Varas10/ROBOT/Rapports/2.Générer un signal de lumière codée/Vlum (jaune) et Vc (bleu).jpg

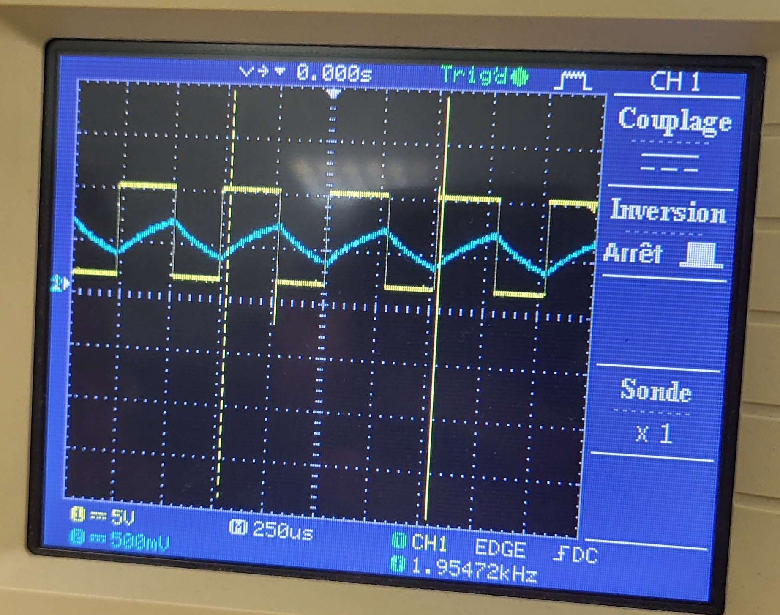
Rapports/2.Générer un signal de lumière codée/Vlum (jaune) et Vc (bleu).jpg
