Varas10/ROBOT/Rapports/6. Visualiser/6.VISUALISER.md

## Projet 6 – **Étude théorique de la visualisation de Vsuivi**

### Objectif :

Mettre en œuvre un système d’indication visuelle permettant de traduire l’état logique de la sortie **Vsuivi** (obtenue après démodulation du signal optique) en allumage ou extinction d’une **LED**. Ce retour visuel est essentiel pour valider la détection d’une piste claire (blanche) ou sombre (noire) par le robot suiveur.

### Données initiales (extrait du cahier des charges) :

|Surface|Vsuivi (V)|LED allumée|
|---|---|---|
|Blanche|≈ 6 V|Oui|
|Noire|≈ 0 V|Non|

### Solution proposée :

L’objectif est de commander une **diode électroluminescente (LED)** à partir de la tension **Vsuivi**. Pour cela, on utilise un montage de **comparateur à seuil** à base d’amplificateur opérationnel, qui :

- compare Vsuivi à une tension de référence (**Vref**, par exemple 3 V),
    
- commande la LED via un transistor de puissance (ex : **NPN** ou **MOSFET**),
    
- protège la LED par une résistance série adaptée.

### Calculs :

- Tension seuil choisie : **Vref = 3 V**
    
- Si Vsuivi>VrefVsuivi > VrefVsuivi>Vref, alors la LED s’allume (surface blanche détectée).
    
- Si Vsuivi<Vref, la LED reste éteinte (surface noire détectée).
    
- Résistance série pour la LED 
	$R_{LED} = V_{suivi} − V_{D}*I_{LED}=6V−2V*20mA=200 \Omega$ (valeur normalise E12 : 220 Ω) où $V_D$ est la chute de tension dans la LED rouge ≈ 2V).

### Adaptation d’impédance :

Le comparateur est conçu pour présenter une **impédance d’entrée élevée** et **ne pas charger le signal Vsuivi**, afin de préserver l'intégrité du signal issu du détecteur de crête.

### Simulation :

- Simulation effectuée dans **MicroCap** ou environnement similaire.
    
- Résultat attendu : la sortie bascule rapidement en fonction du dépassement du seuil Vref, et commande proprement l’allumage de la LED.

---

## Séance 6 – **Implémentation du montage et validation expérimentale**

### Objectif :

Réaliser physiquement le circuit de visualisation sur plaque d’essai, le tester avec des signaux réels et vérifier le bon fonctionnement de la LED en fonction de la valeur de **Vsuivi**.

### Montage réalisé :

- Comparateur avec AOP ou comparateur dédié (type LM393).
    
- Entrée non-inverseuse connectée à Vsuivi.
    
- Entrée inverseuse connectée à Vref fixée par pont diviseur de tension.
    
- Sortie du comparateur connectée à une LED + résistance via un **transistor de commutation NPN**.

### Expériences menées :

- Cas 1 – **Surface blanche** :
    
    - Vsuivi mesuré ≈ 6 V
        
    - Vsuivi > Vref → LED **allumée** 
		
	- ![[surface blanche- seance 6.jpg]]
- Cas 2 – **Surface noire** :
    
    - Vsuivi mesuré ≈ 0 V
        
    - Vsuivi < Vref → LED **éteinte** 
        
	- ![[surface noir - séance 6.jpg]]
### Ajustements :

- Si besoin, Vref peut être modifiée pour affiner la sensibilité du déclenchement.
    
- La résistance série peut être recalculée selon la couleur de la LED utilisée (chute de tension différente pour LED bleue, verte, etc.).

### Conclusion :

Le circuit de visualisation est opérationnel et conforme aux exigences. Il permet de **traduire visuellement l’état du capteur IR** après amplification et démodulation, ce qui est essentiel pour la vérification manuelle ou le débogage du système. Ce montage constitue la dernière étape de la chaîne de traitement du signal sur la carte SUIVI.****
