Varas10/ROBOT/La carte Suiveur.pptx

## La carte Suiveur

Par Julien & Evan

## Sommaire

- Schéma de fonction
- Les yeux
- Oscilateur
- Filtre
- Ampificateur
- Détecteur de crète
- LED d’état

## Schéma de fonction

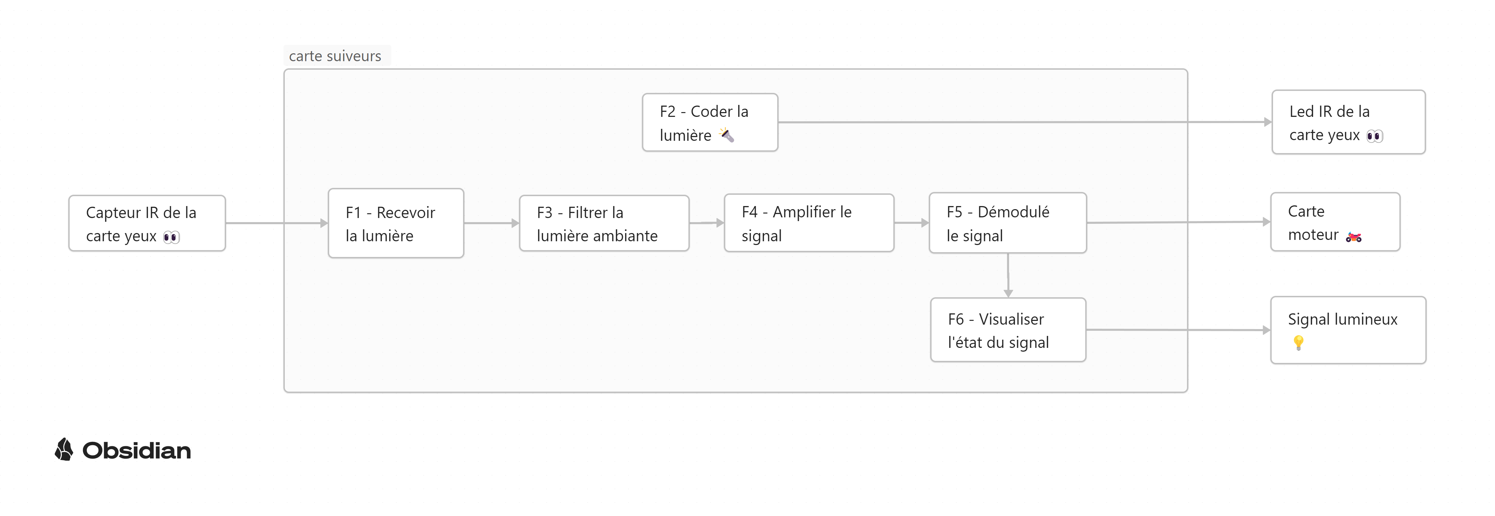
[picture p3: figure]

## Les yeux

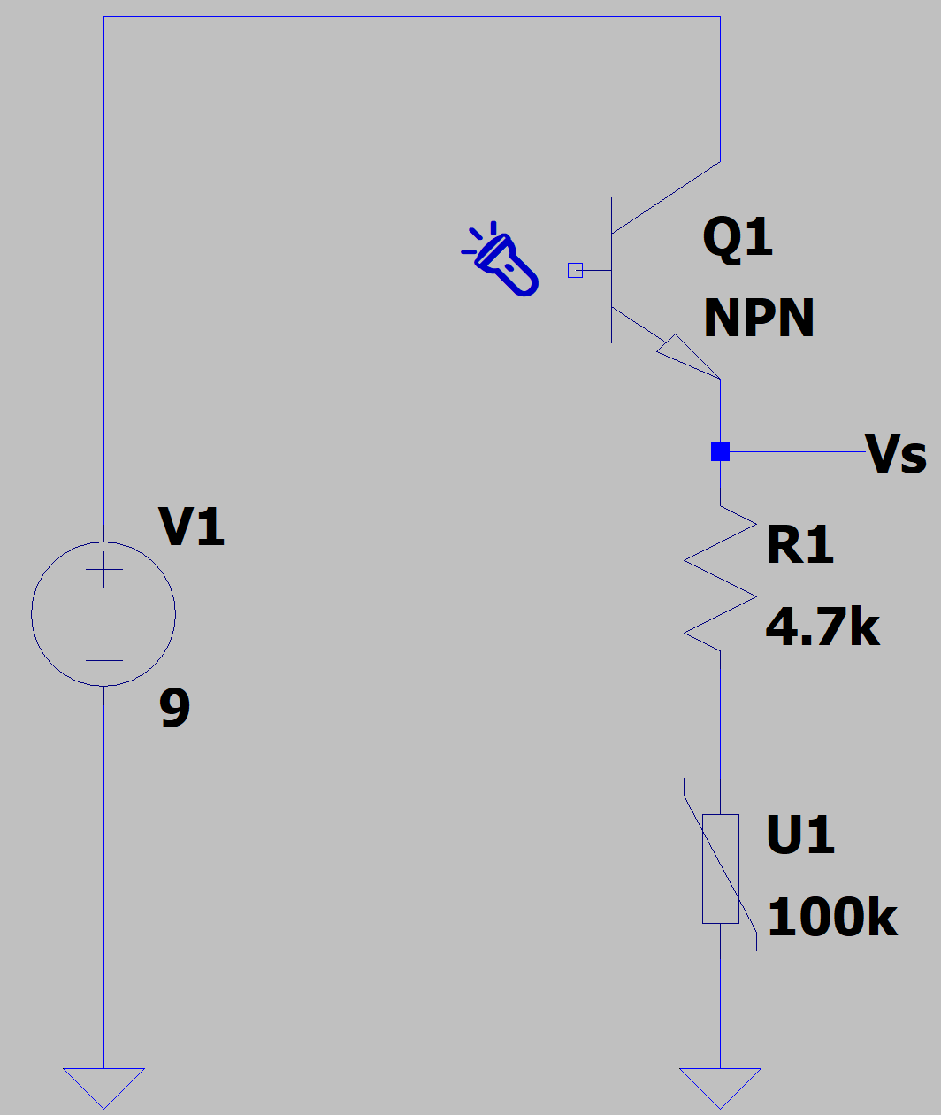
[picture p4: figure]
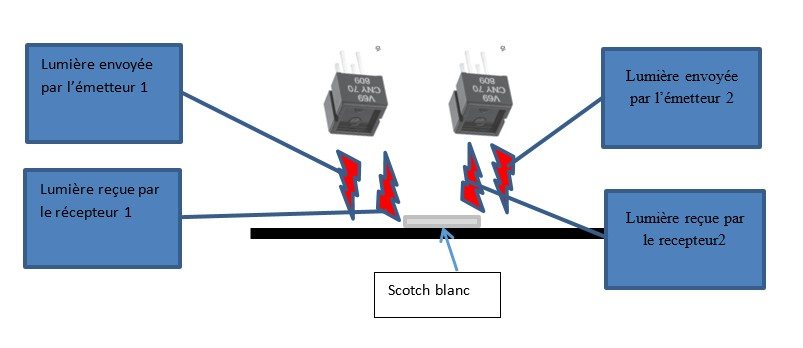
[picture p5: figure]
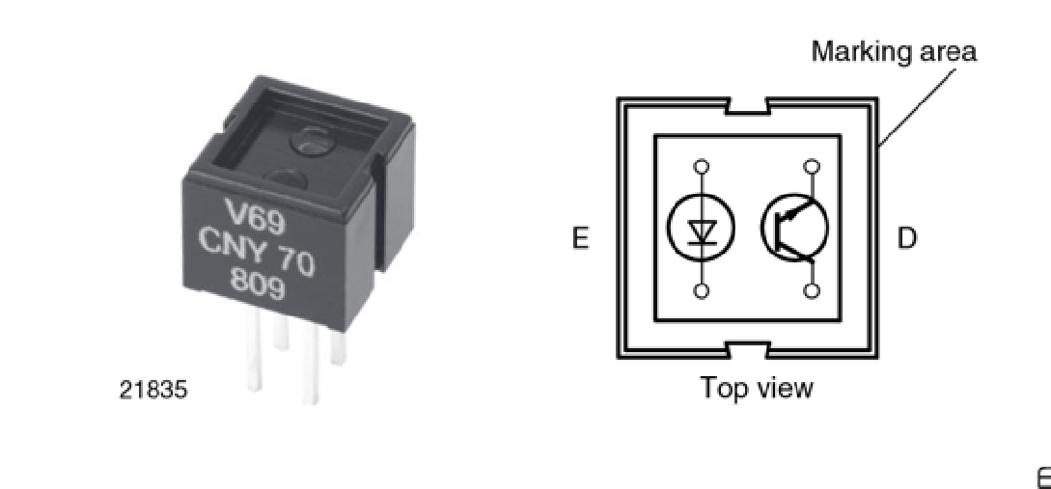
[picture p6: figure]

## Slide 5

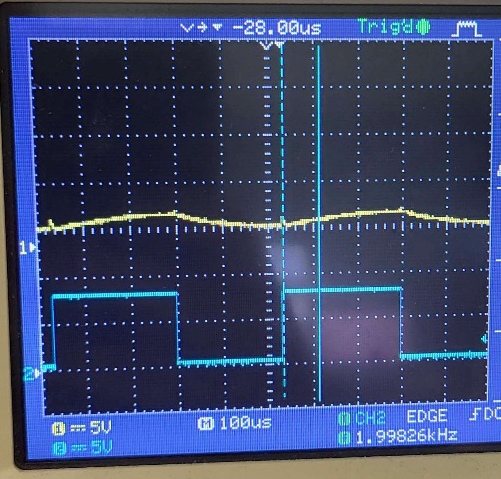
[picture p7: figure]

Surface noir

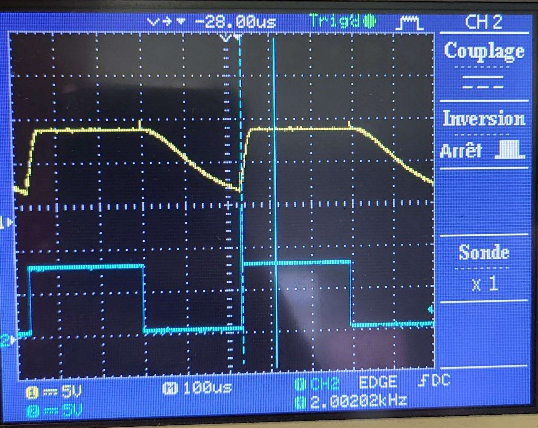
[picture p8: figure]

Surface Blanche

## Oscillateur

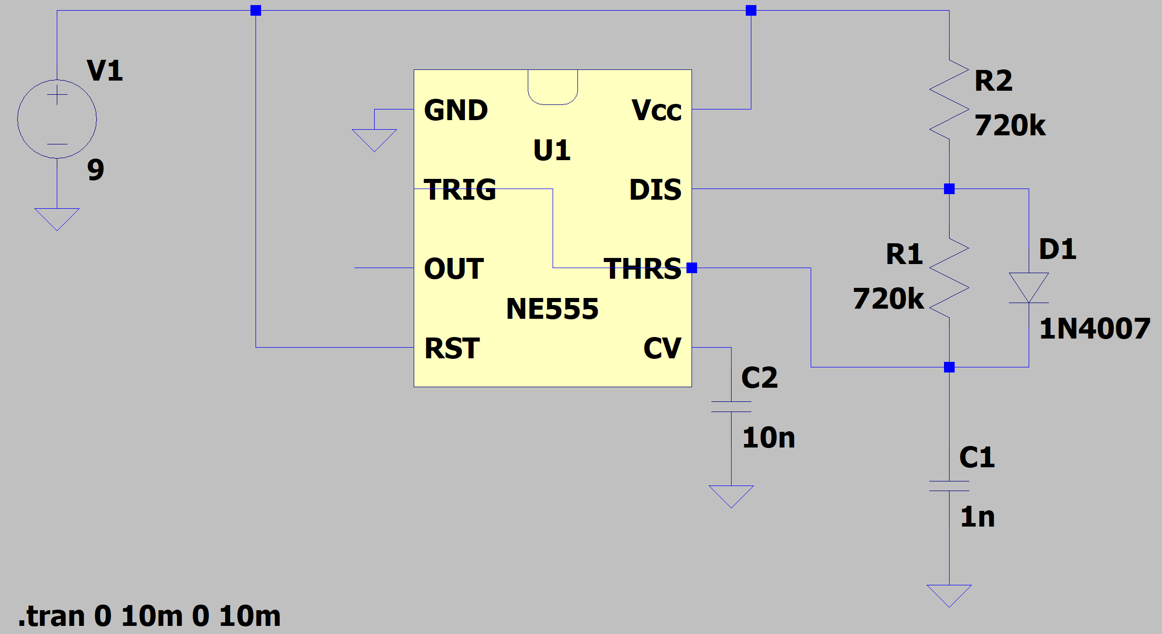
[picture p9: figure]
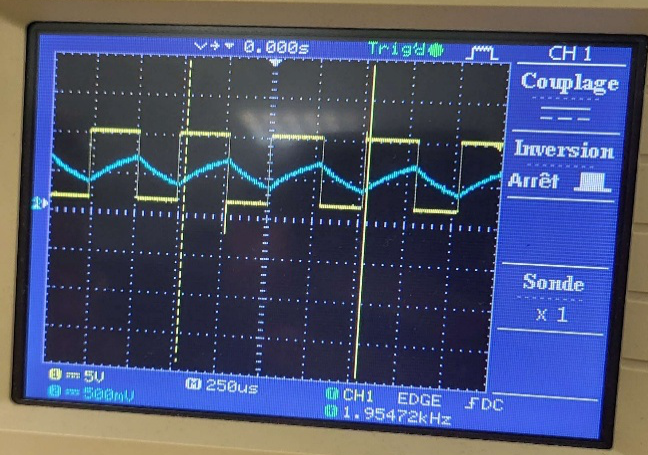
[picture p10: figure]

## Filtre

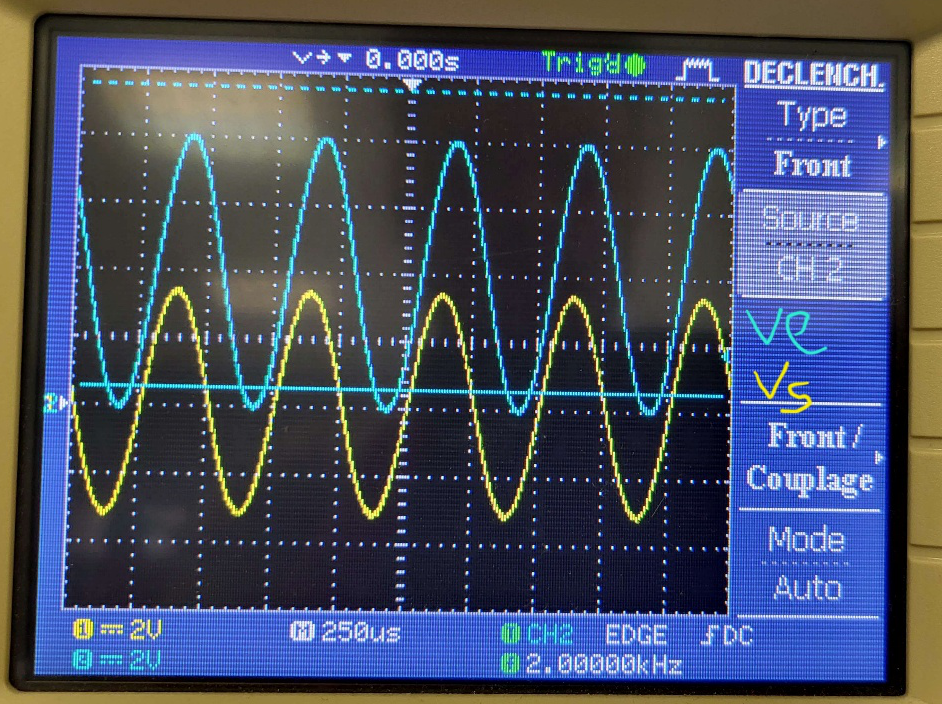
[picture p11: figure]

- Fc = 200Hz

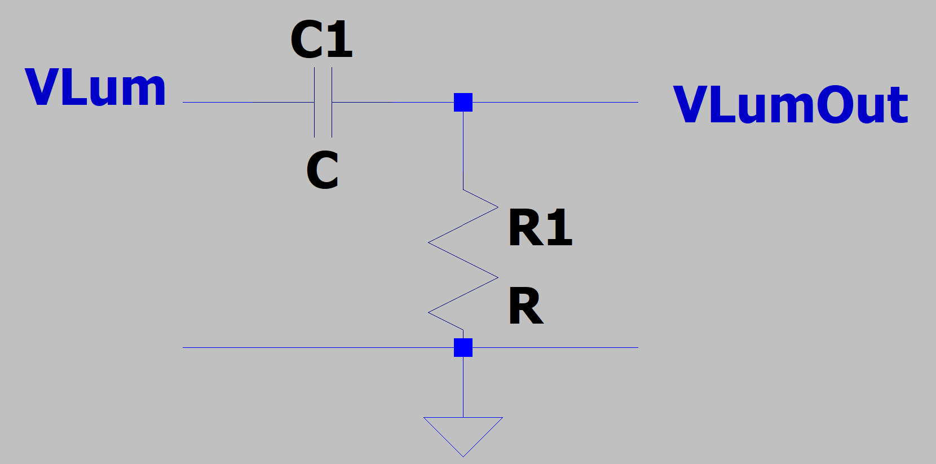
[picture p12: figure]
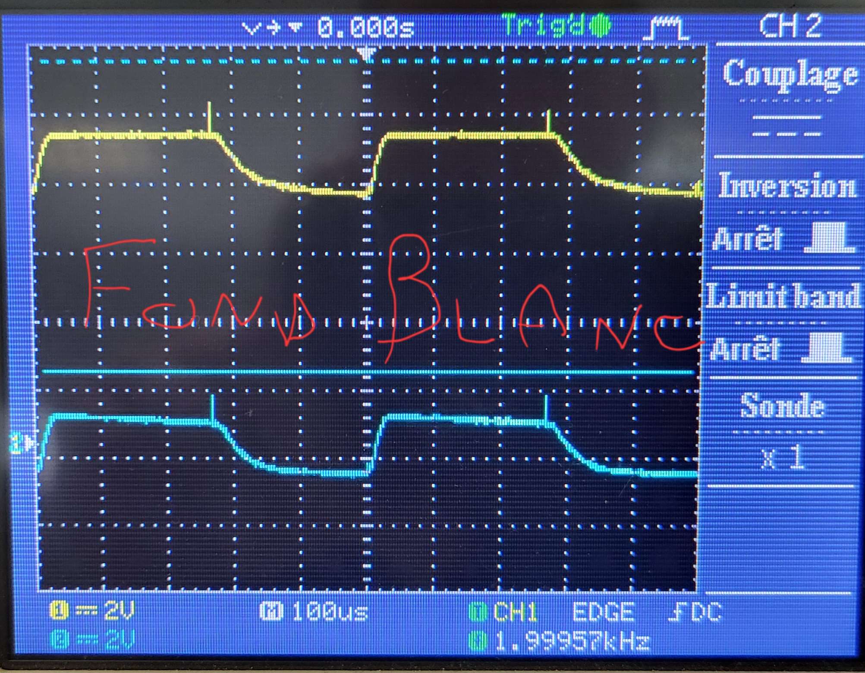
[picture p13: figure]
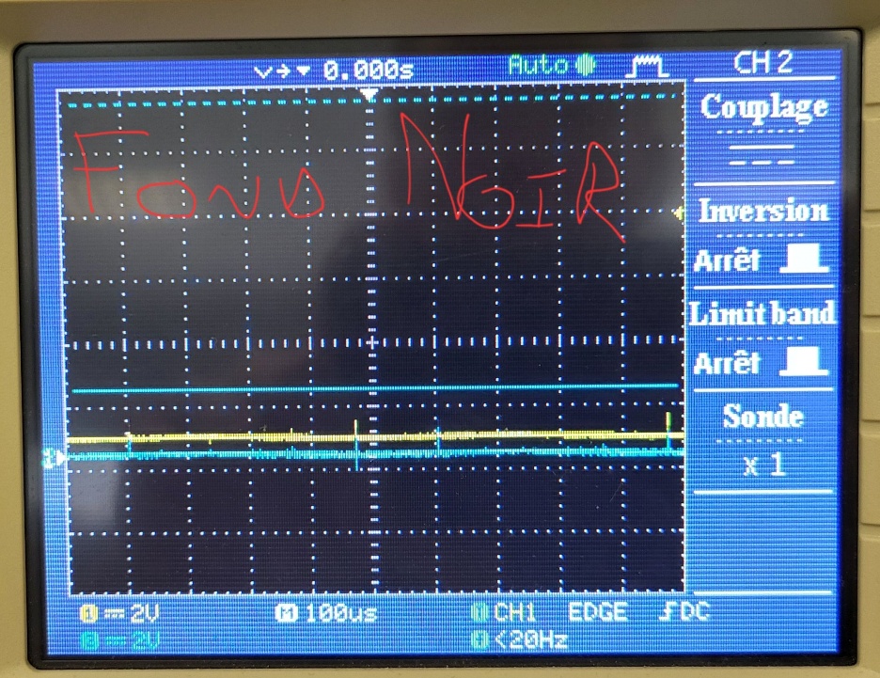
[picture p14: figure]

## Amplificateur

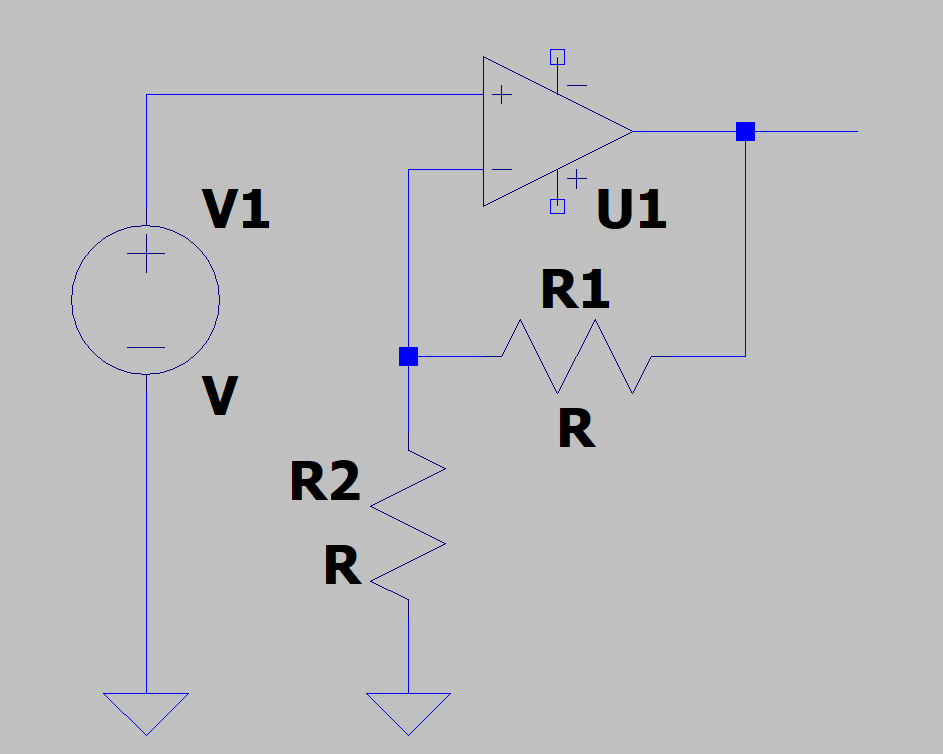
[picture p15: figure]
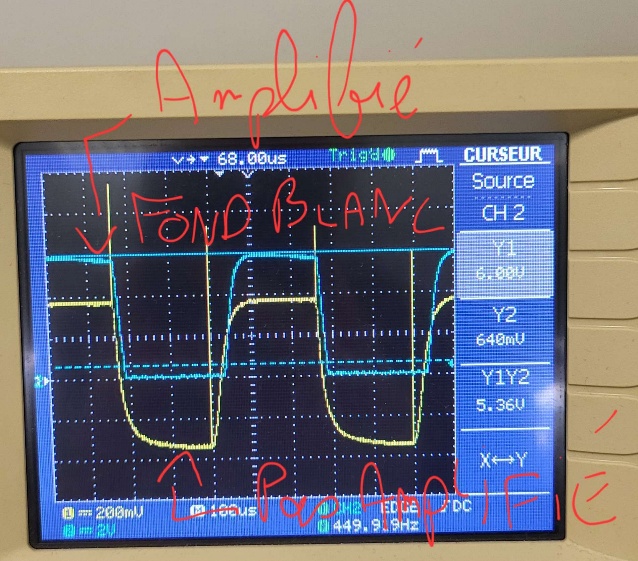
[picture p16: figure]
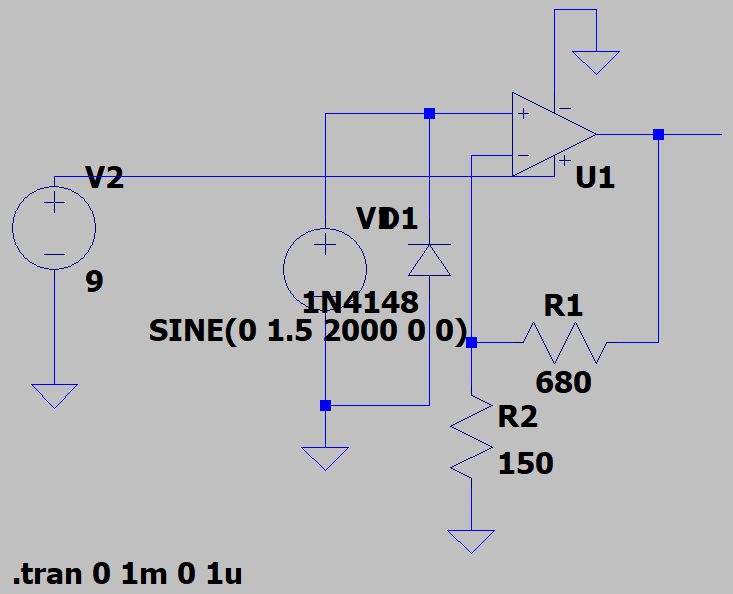
[picture p17: figure]
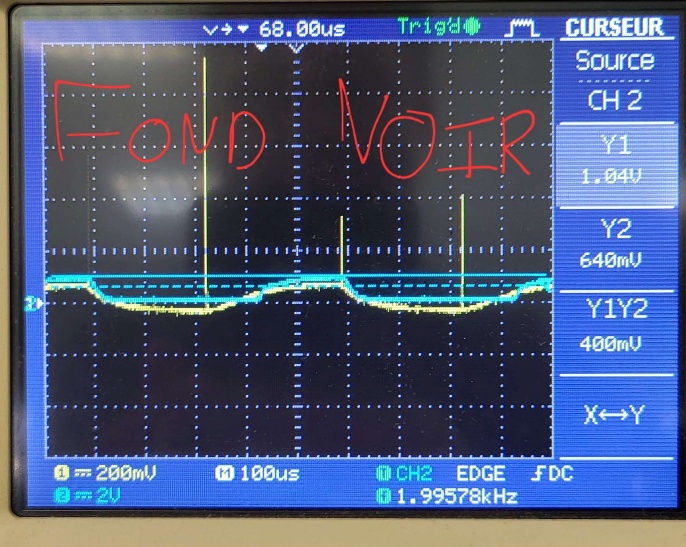
[picture p18: figure]

## Détecteur de crête

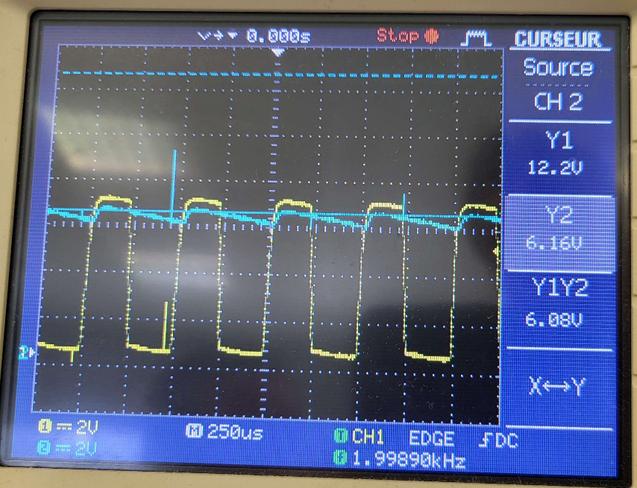
[picture p19: figure]
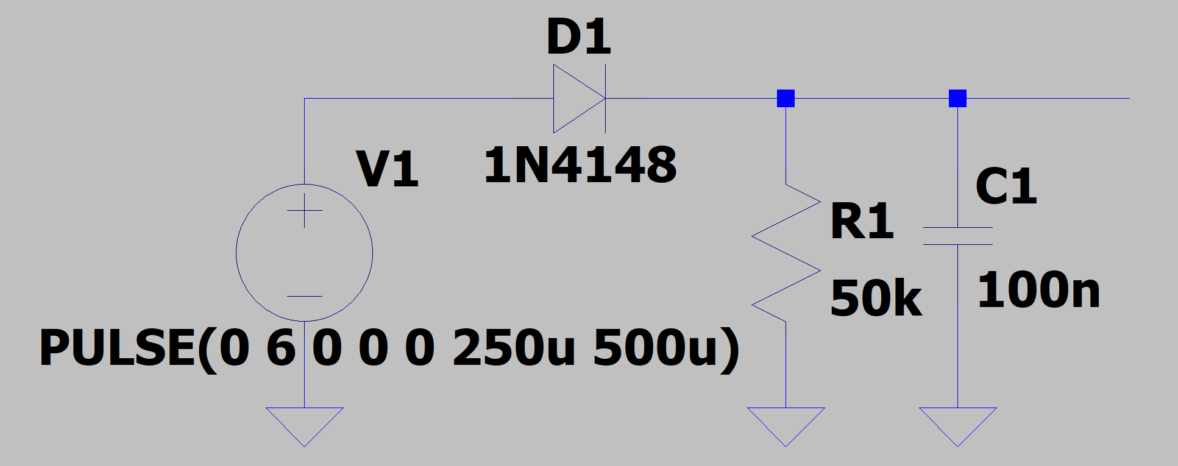
[picture p20: figure]
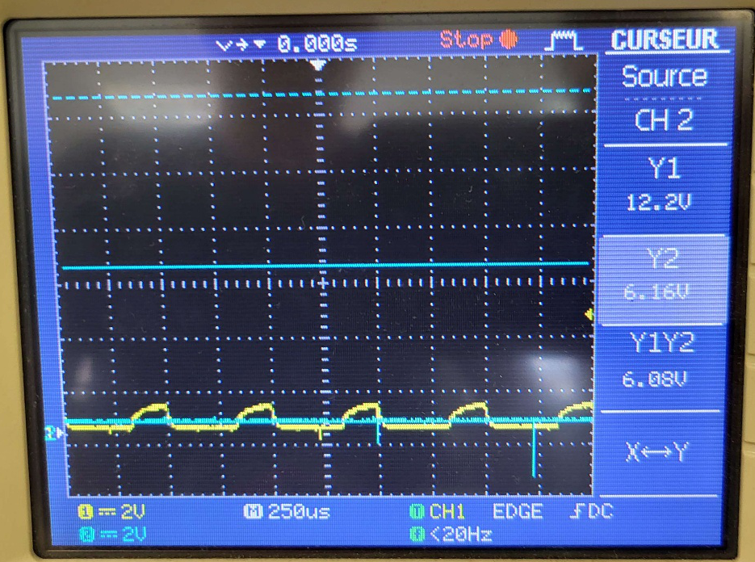
[picture p21: figure]
