Varas10/ROBOT/Rapports/schéma ordre 1 et 2.pptx

Information sonore

Informations lumineuses (ou de position)

Suivre une ligne de manière autonome

Information lumineuse d’état

Déplacement

Informations lumineuses de positon

## Slide 2

Suivre une ligne

Détecter un claquement de mains

Se repérer par rapport à la piste

Information d’autorisation de déplacement

F1

Commander le déplacement

F3

F2

Information lumineuse d’état

Déplacement

Informations lumineuses de positon

Information sonore

Informations lumineuses de repérage
