Varas10/ROBOT/facicule julien/simu/Passe_Haut/calculs filtre passe haut.pdf

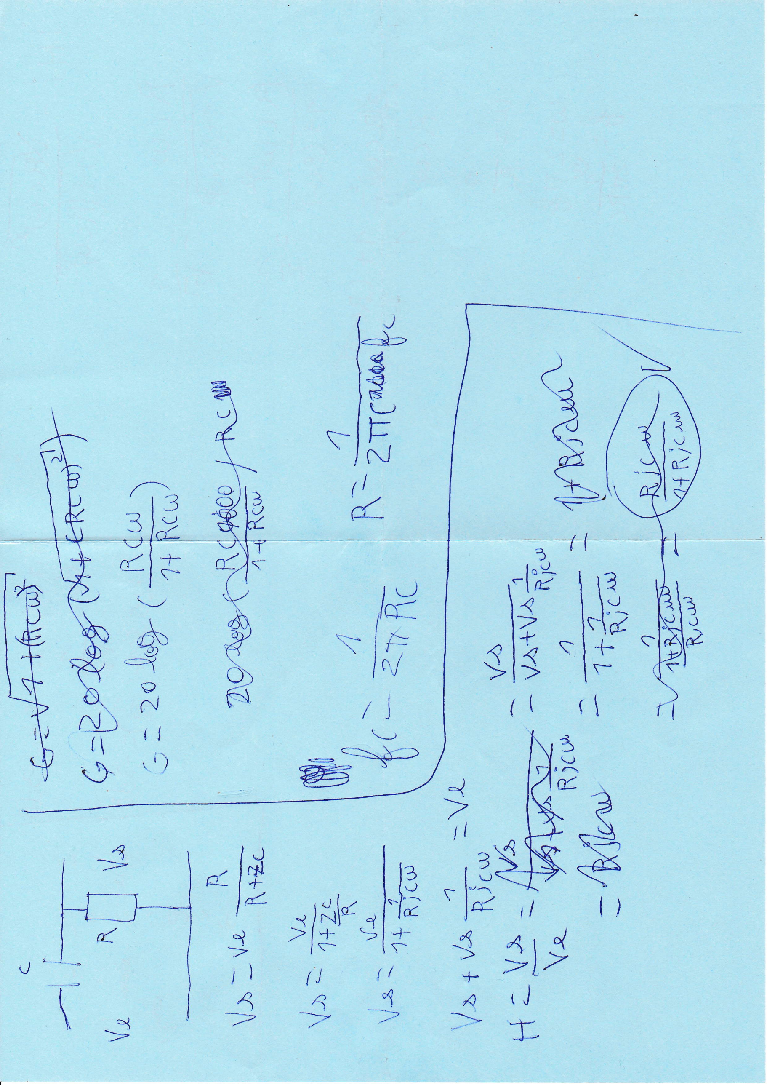
[picture p32: page 1]

e\ 2

'rJ
sa
1"y

(J
l'-=+-> (a
\..ê l=€ldlL-r
\-1tr
1NJ
1l
{_

?

\Ë

tlt)
\r
q-\
c +
§-
(( (\

§

,ri

-l \*r' . .-

1..''-'-,. i ,t-*-
.i
tÇ'I IJ
ti

## \-J <\b)s

1 ((
I .:l
'-'l ft<

)-ls

-t:)\)

### c/ \' --lç

\-"--l.
_t {2§:, *\ Ç

r-{
iJ
'i) | €ry
É
-)
_§

\.:-1'
Àr< \ Cr-s-r
t!()
"1 r
d

;t>

## * /llld

,
l\--
(j

î-_J2

d

## tl I

,3lLl çl?

l*&J

+-

/1 âY

.13

+- r

t;

### Q. lf

l*:- {

1.>
ll

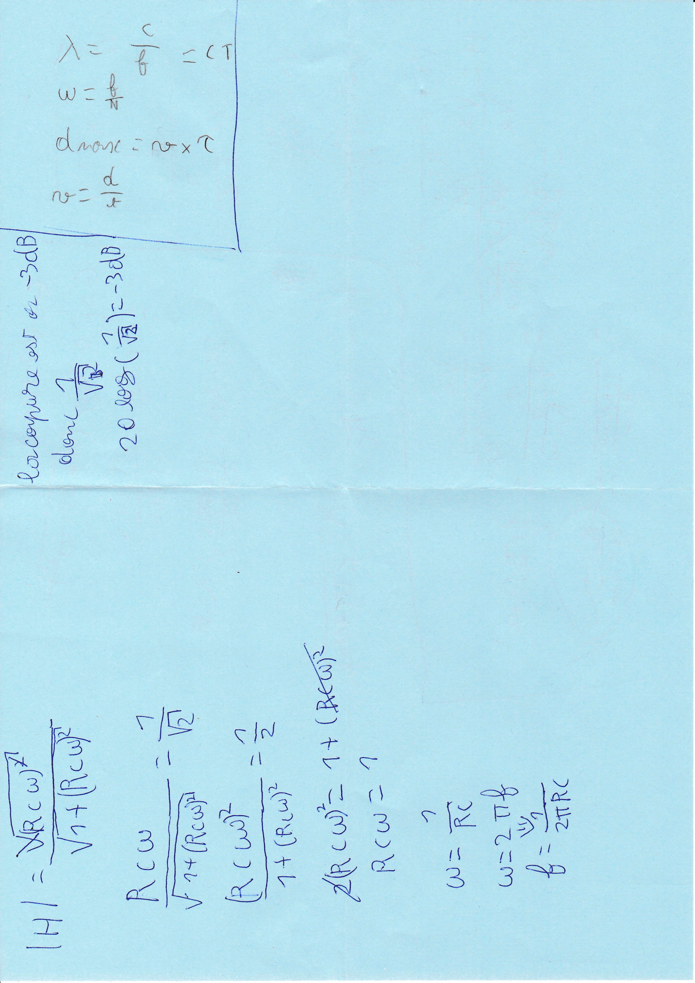
[picture p33: page 2]

.?(T

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
(:{ J

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
,.-,
-r l-

# Ëil

1{ .:_:_)

h
E

3
\-J
{

F;d l"

\-, ty

a^,

I
ri r-
ti-^d \ \-7
,.)
ffb ),1, Ç-\{- 'tr\ 'l-' | -'là

,

.ol
-lcÇSrJ *_) \

.Ç)

\d- \z
U

4
-r
\" ç-

# .--t, iy r\àî»\ r

-'

### l{ /l tt

3 3 ⁻ÀE)

'^J
?-:l\
-)J

"t-
ç-
>=

.lB

rl

# çld

t\

r(
T

(l (\ À'6- 2
2J
.-J \l
,& d- \r\
