Varas10/ROBOT/Document ressources/Images/3 du 1.1.png

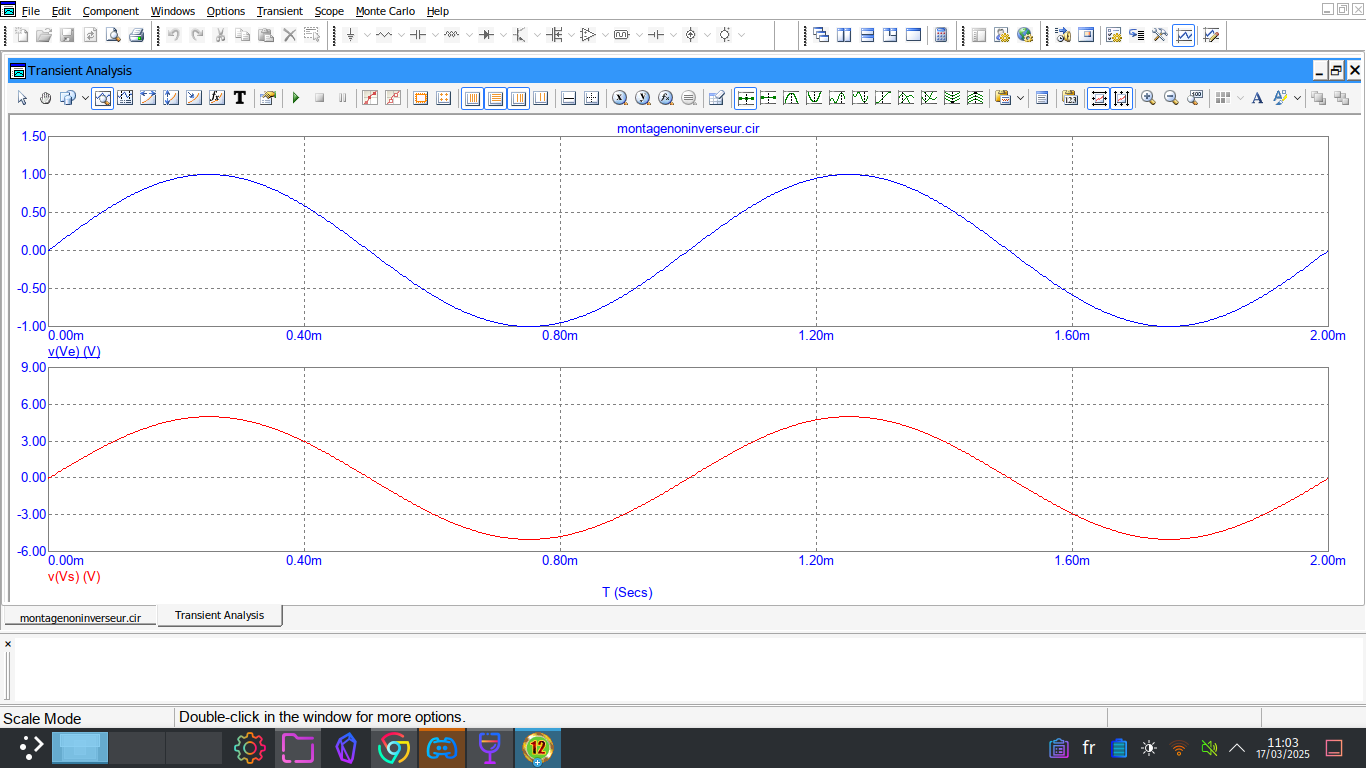
Document ressources/Images/3 du 1.1.png
