Varas10/ROBOT/Document ressources/Images/3.1 du 1.2.png

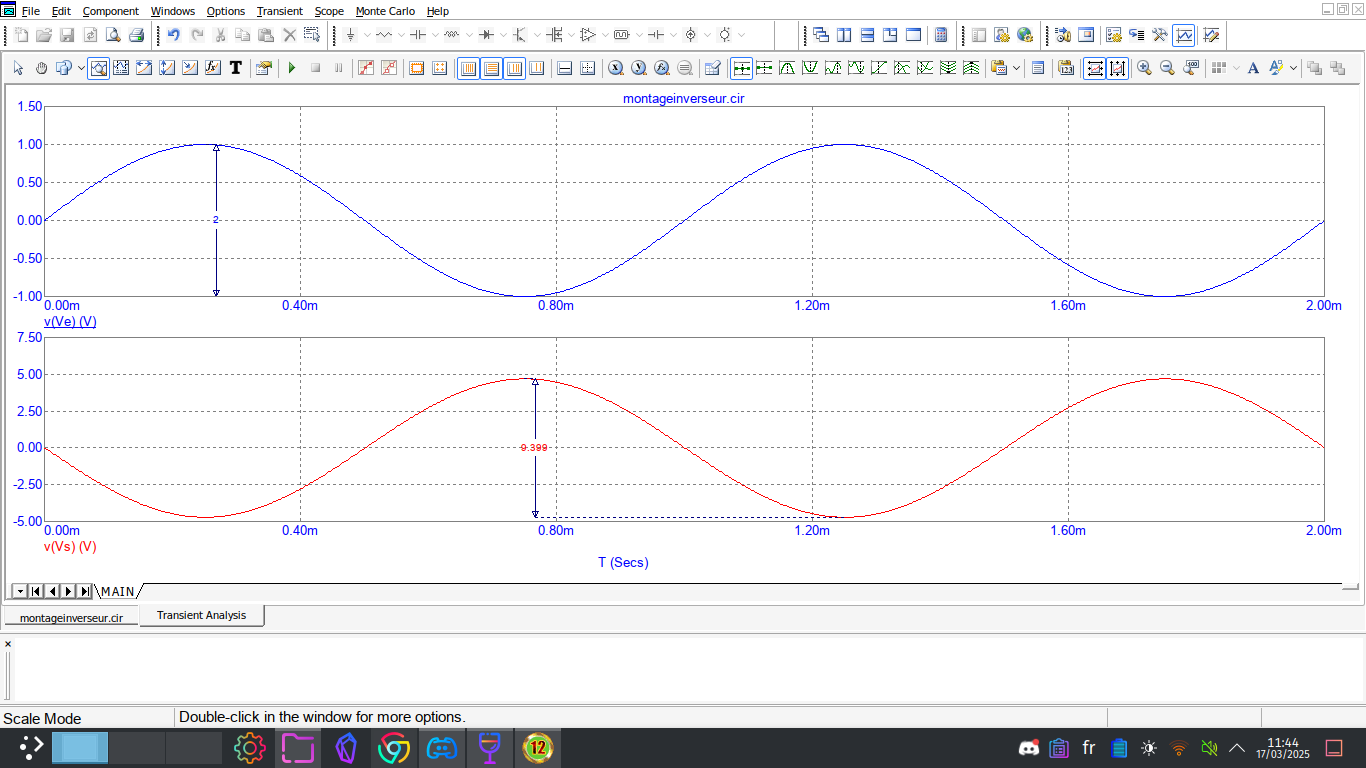
Document ressources/Images/3.1 du 1.2.png
