Varas10/ROBOT/Document ressources/Images/images 2 du 3 du 1.1.png

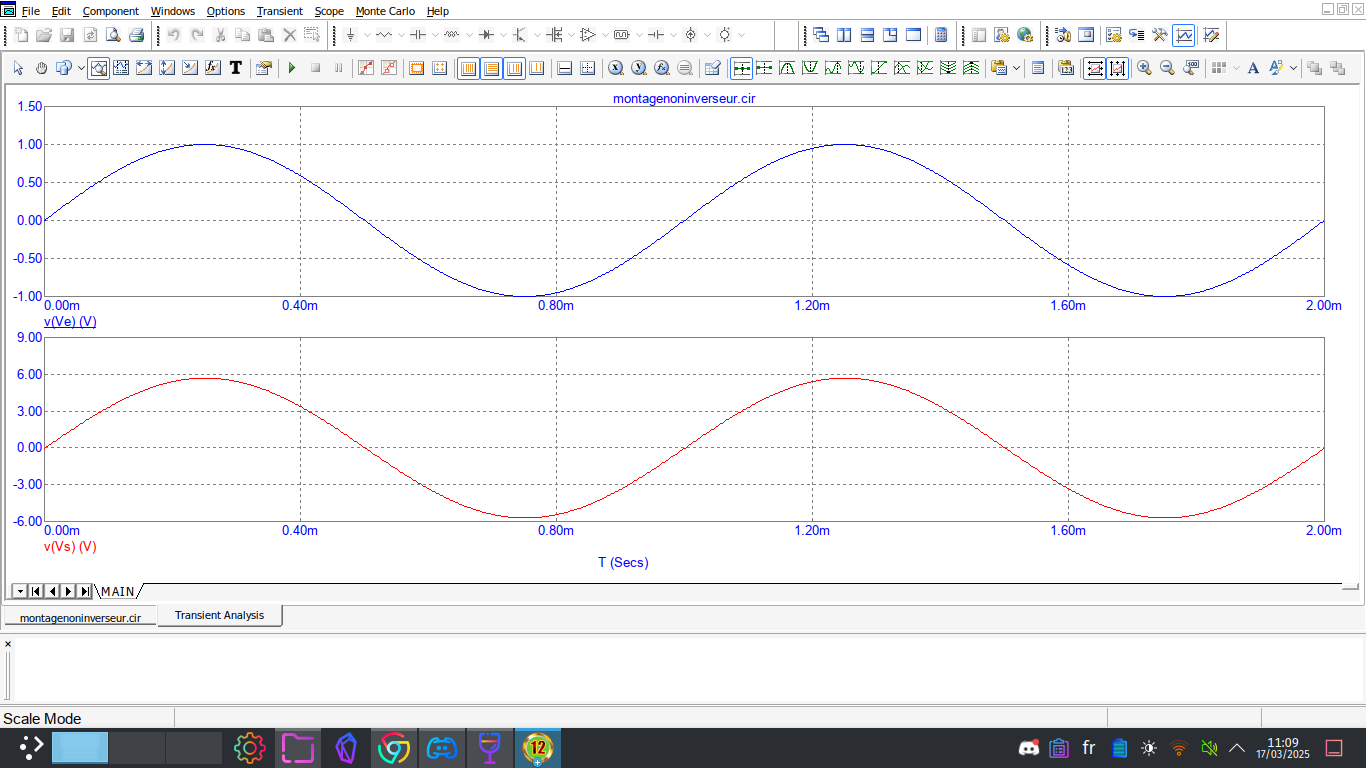
Document ressources/Images/images 2 du 3 du 1.1.png
