Varas10/ROBOT/Rapports/0.Rapport préliminaire/schéma ordre 2 -  seance 0.png

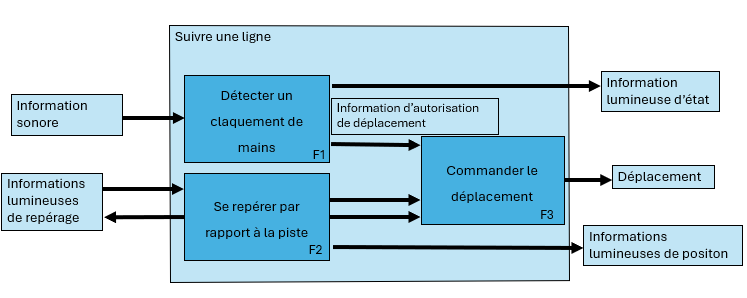
Rapports/0.Rapport préliminaire/schéma ordre 2 - seance 0.png
