Varas10/ROBOT/Rapports/1.Emettre et Recevoir de la lumière/Courbe charge f(Ic et Vce) -  seance 1.png

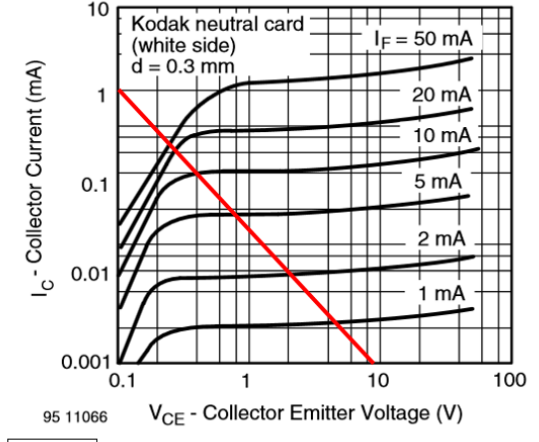
Rapports/1.Emettre et Recevoir de la lumière/Courbe charge f(Ic et Vce) - seance 1.png
