Varas10/ROBOT/Rapports/1.Emettre et Recevoir de la lumière/courbes capteur pour noir -  seance 1.jpg

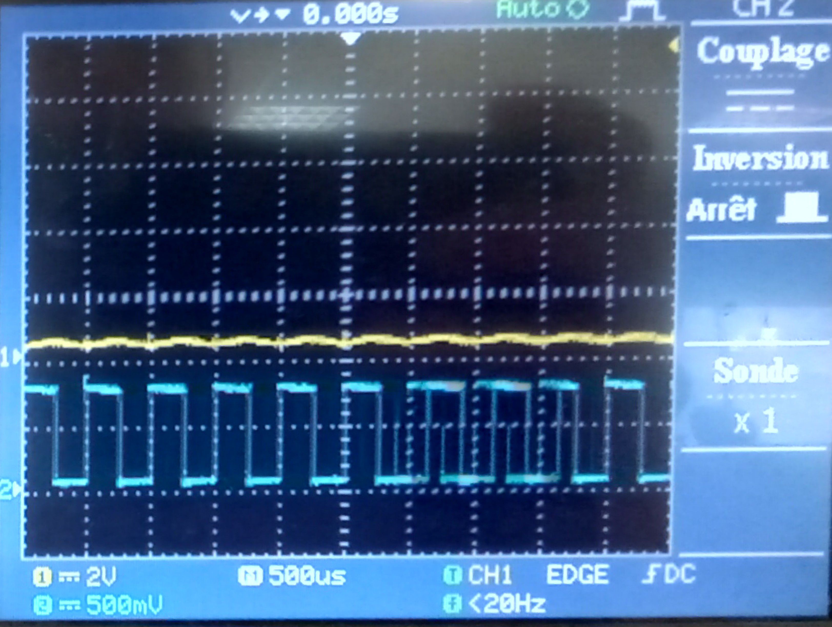
Rapports/1.Emettre et Recevoir de la lumière/courbes capteur pour noir - seance 1.jpg
