Varas10/ROBOT/Rapports/1.Emettre et Recevoir de la lumière/Lumière a 10 - seance 1.png

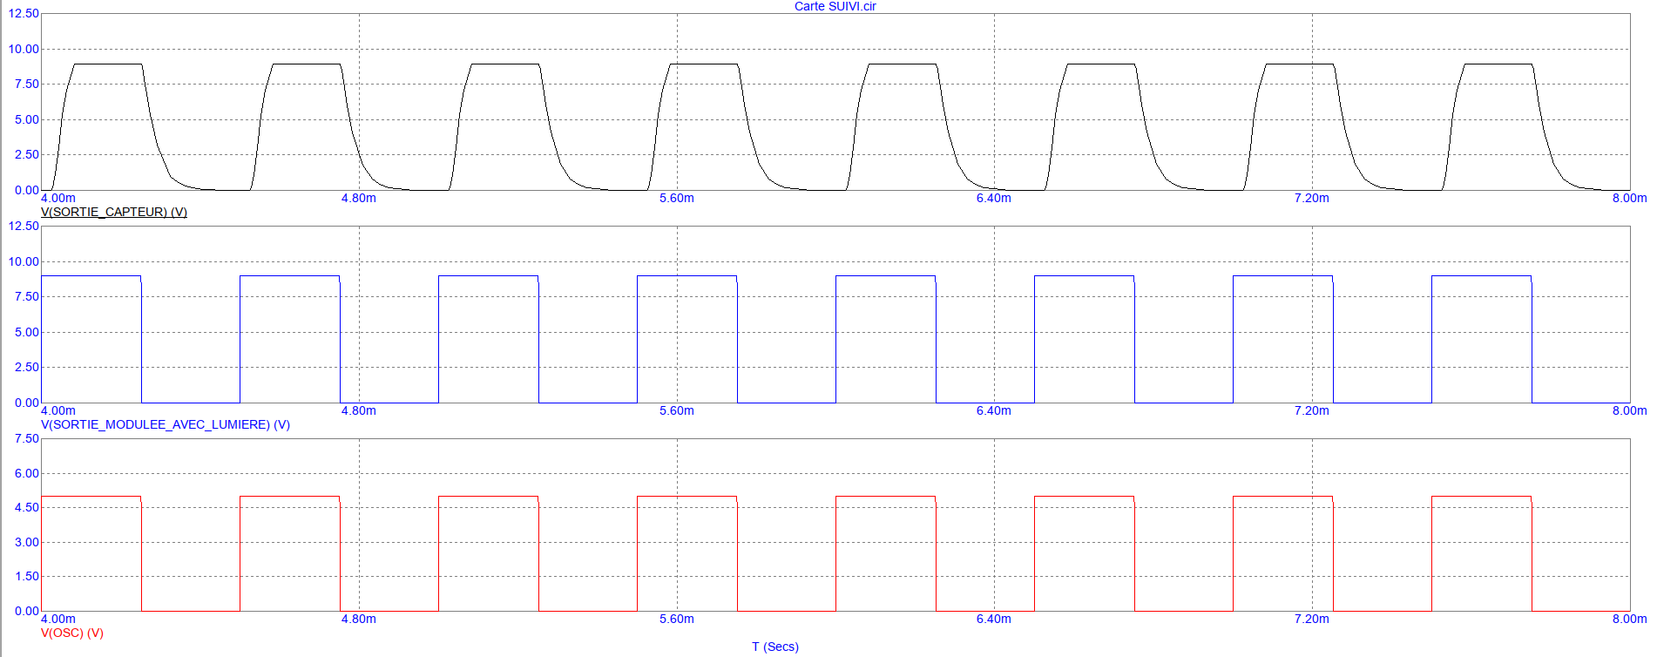
Rapports/1.Emettre et Recevoir de la lumière/Lumière a 10 - seance 1.png
