Varas10/ROBOT/Rapports/1.Emettre et Recevoir de la lumière/lumière à 1 - seance 1.png

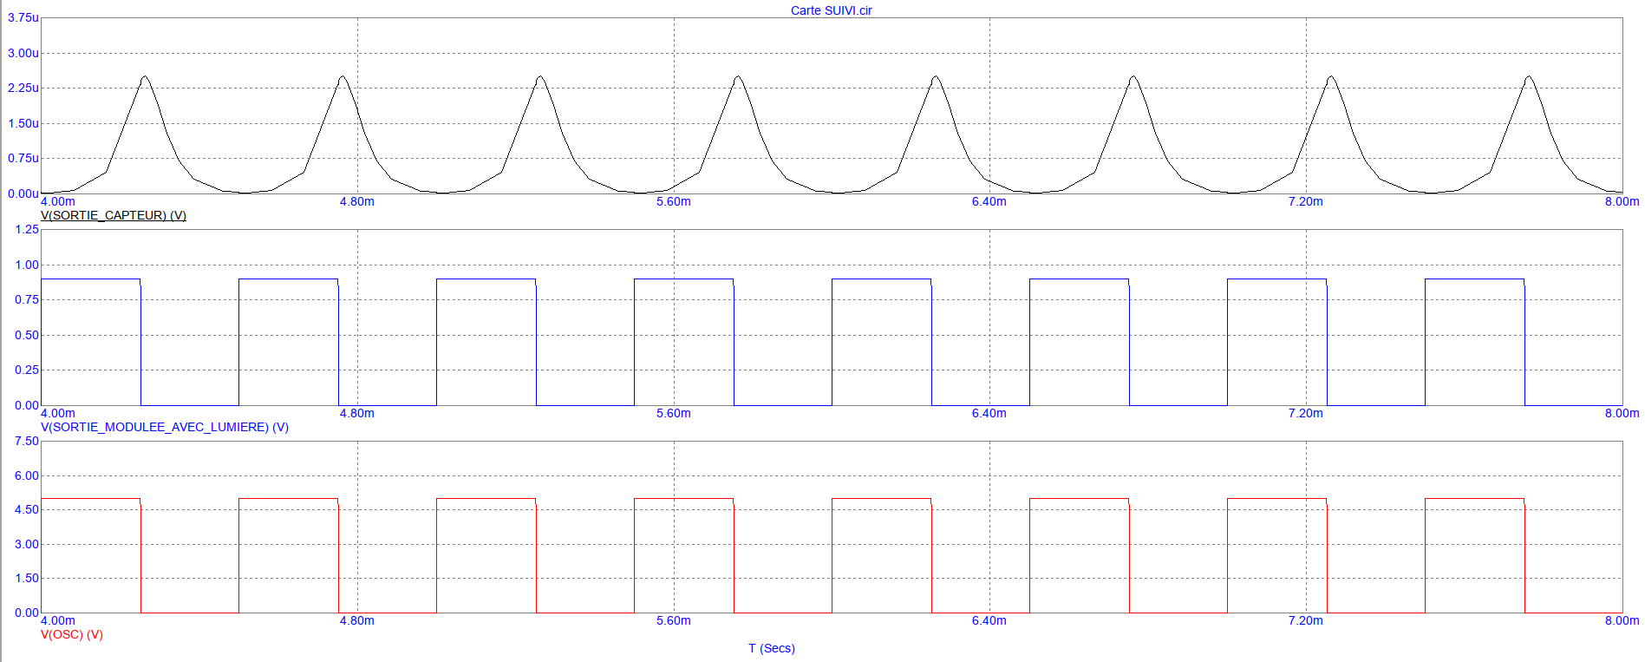
Rapports/1.Emettre et Recevoir de la lumière/lumière à 1 - seance 1.png
