Varas10/ROBOT/Rapports/1.Emettre et Recevoir de la lumière/lumière à 5 - seance 1.png

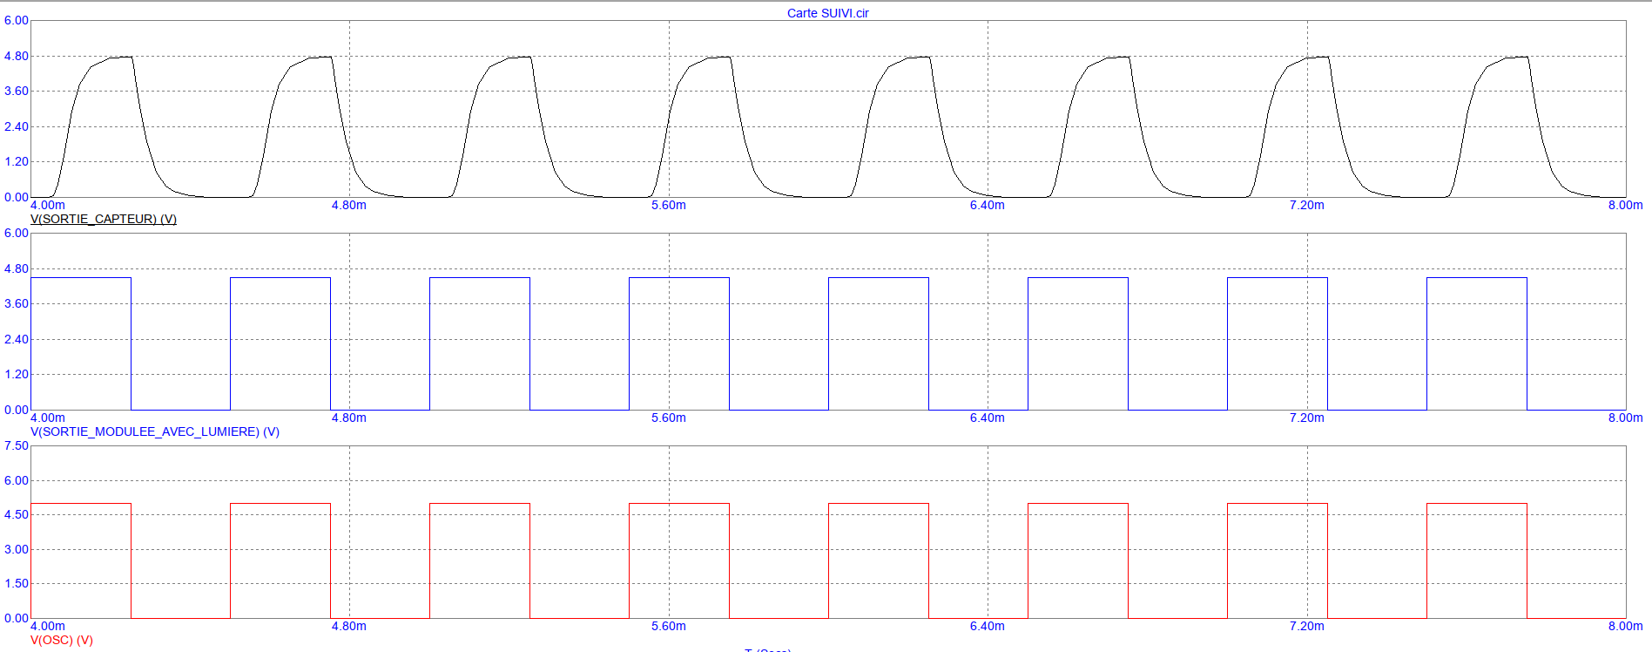
Rapports/1.Emettre et Recevoir de la lumière/lumière à 5 - seance 1.png
