Varas10/ROBOT/Rapports/1.Emettre et Recevoir de la lumière/Routage, chemin du courant entre les deux capteurs - Seance 1.jpg

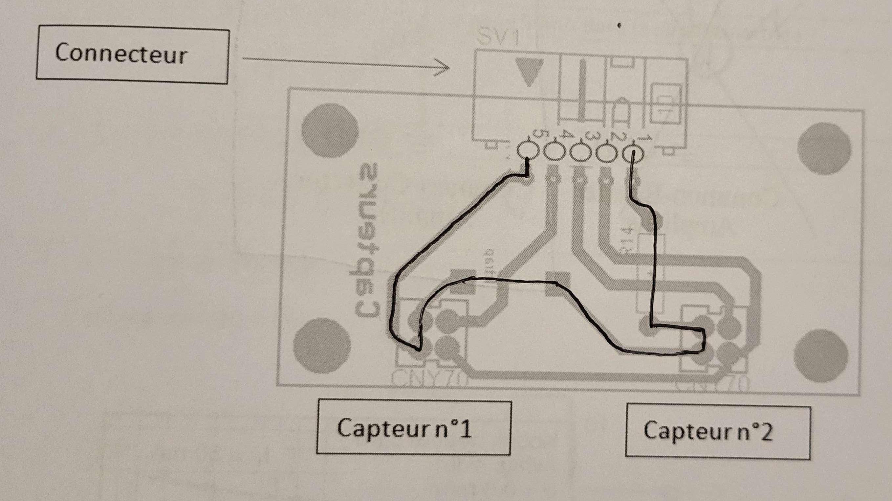
Rapports/1.Emettre et Recevoir de la lumière/Routage, chemin du courant entre les deux capteurs - Seance 1.jpg
