Varas10/ROBOT/Rapports/1.Emettre et Recevoir de la lumière/signal Vce et Vout par rapport à Vlum - seance 1.png

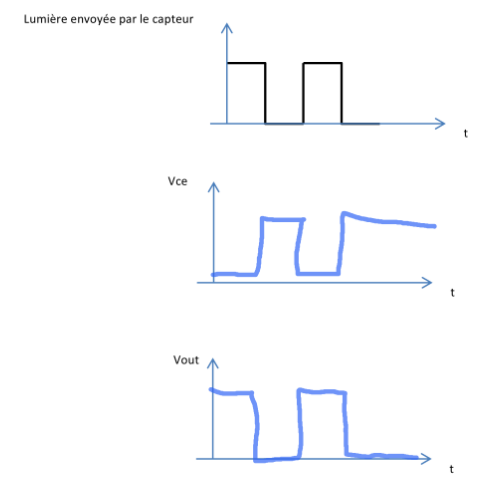
Rapports/1.Emettre et Recevoir de la lumière/signal Vce et Vout par rapport à Vlum - seance 1.png
