Varas10/ROBOT/Rapports/1.Emettre et Recevoir de la lumière/Sortie module avec lumière - seance 1.png

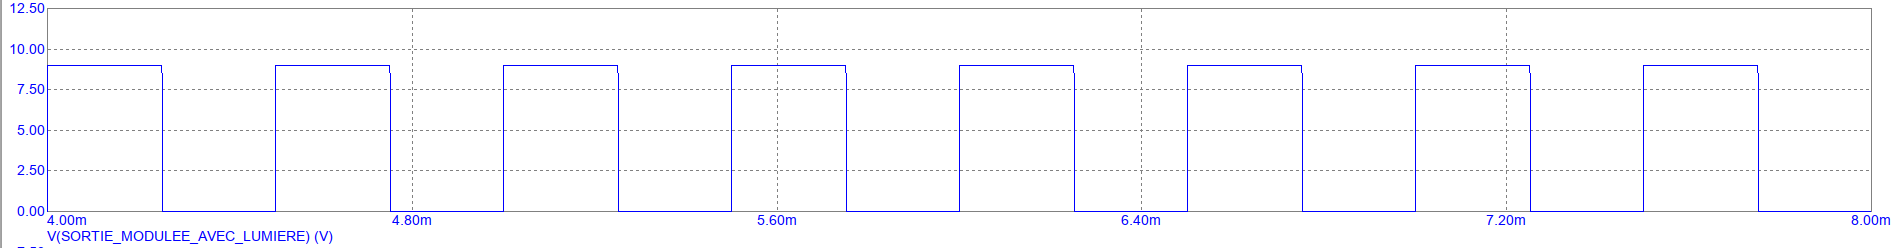
Rapports/1.Emettre et Recevoir de la lumière/Sortie module avec lumière - seance 1.png
