Varas10/ROBOT/Rapports/1.Emettre et Recevoir de la lumière/sortie module avec lumière entre blanc et noir - seance 1.png

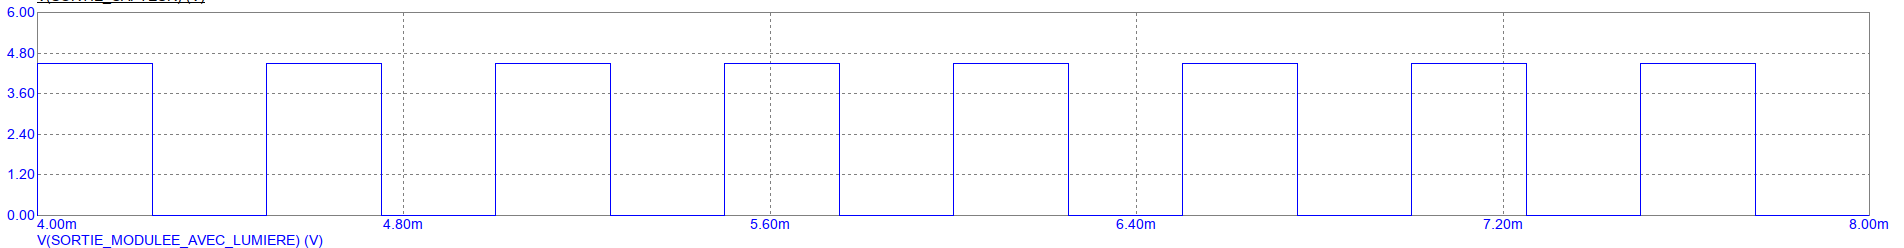
Rapports/1.Emettre et Recevoir de la lumière/sortie module avec lumière entre blanc et noir - seance 1.png
