Varas10/ROBOT/Rapports/2.Générer un signal de lumière codée/Capteur marqueur.png

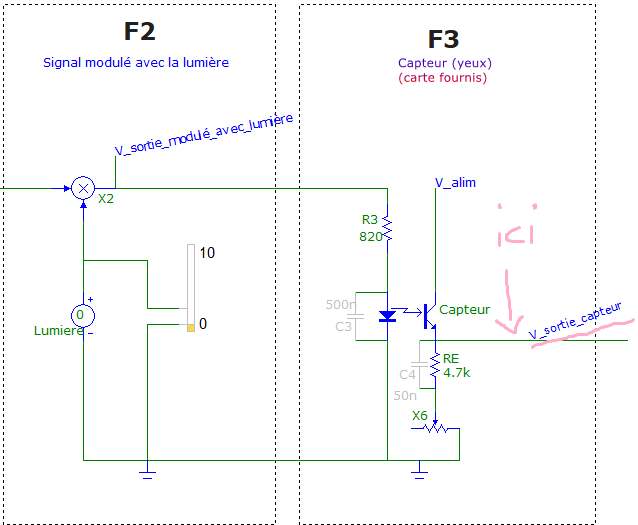
Rapports/2.Générer un signal de lumière codée/Capteur marqueur.png
