Varas10/ROBOT/Rapports/2.Générer un signal de lumière codée/fond blanc seance 2.jpg

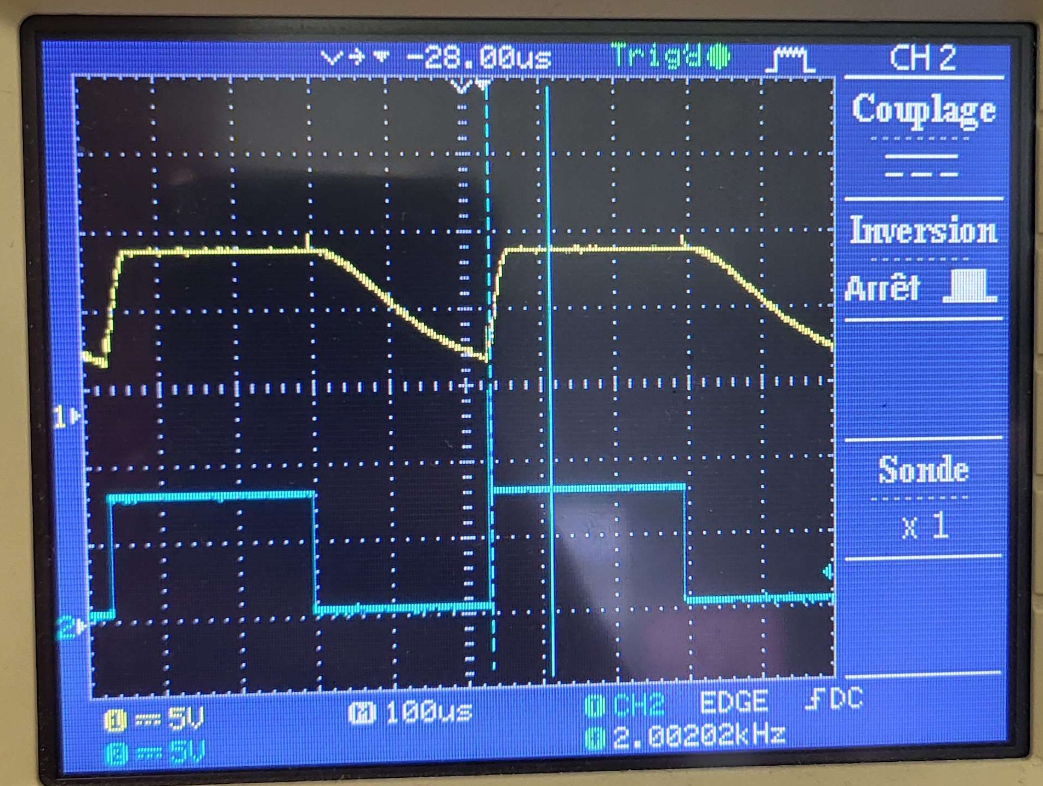
Rapports/2.Générer un signal de lumière codée/fond blanc seance 2.jpg
