Varas10/ROBOT/Rapports/2.Générer un signal de lumière codée/oscillateur marqueur.png

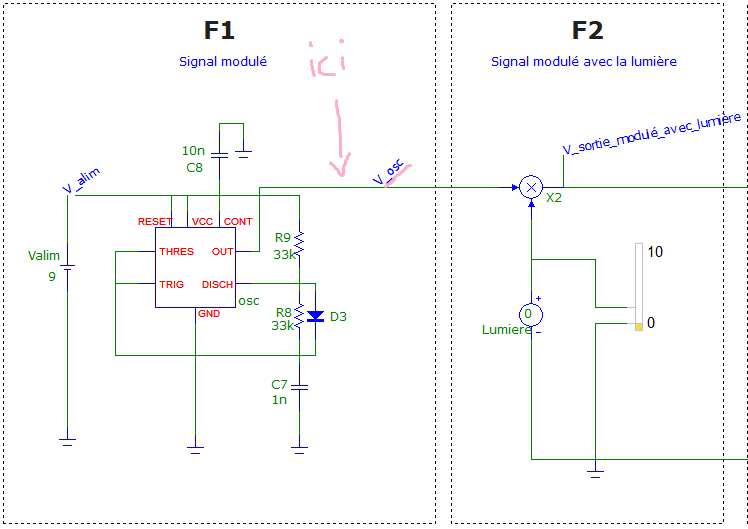
Rapports/2.Générer un signal de lumière codée/oscillateur marqueur.png
