Varas10/ROBOT/Rapports/2.Générer un signal de lumière codée/signal carré généré et envoyé à l'émetteur.png

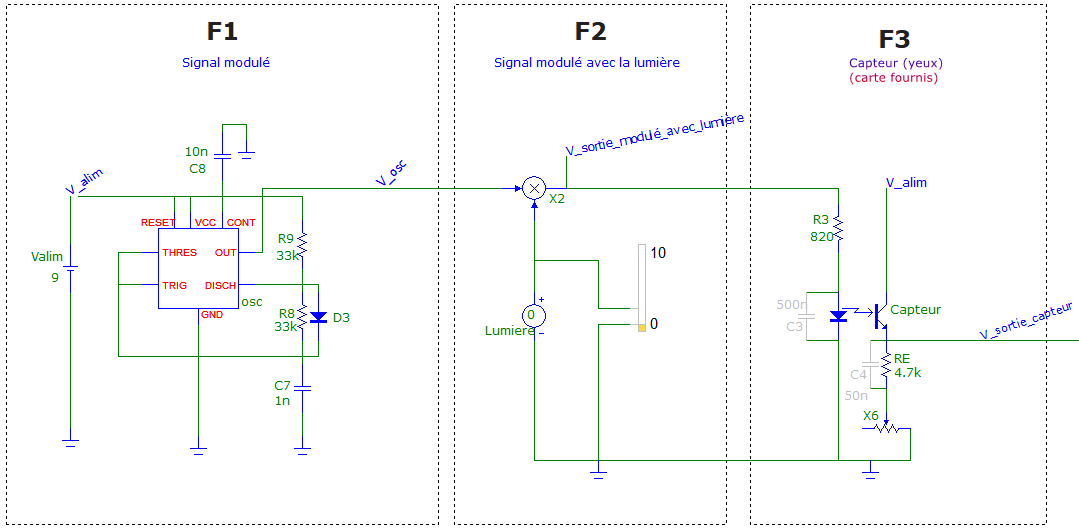
Rapports/2.Générer un signal de lumière codée/signal carré généré et envoyé à l'émetteur.png
