Varas10/ROBOT/Rapports/3.Mettre en forme Vout/filtrage ve.png

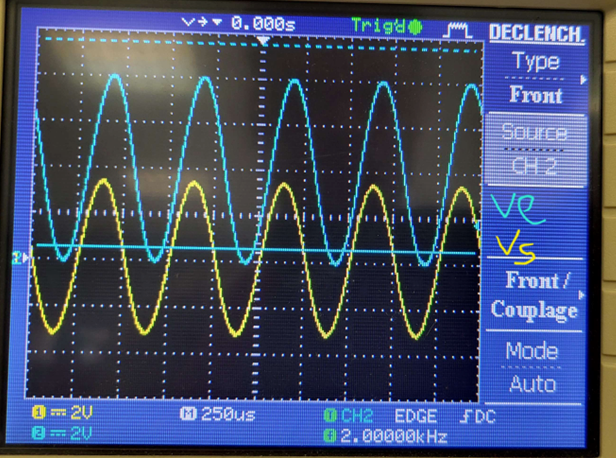
Rapports/3.Mettre en forme Vout/filtrage ve.png
