Varas10/ROBOT/Rapports/3.Mettre en forme Vout/filtre.png

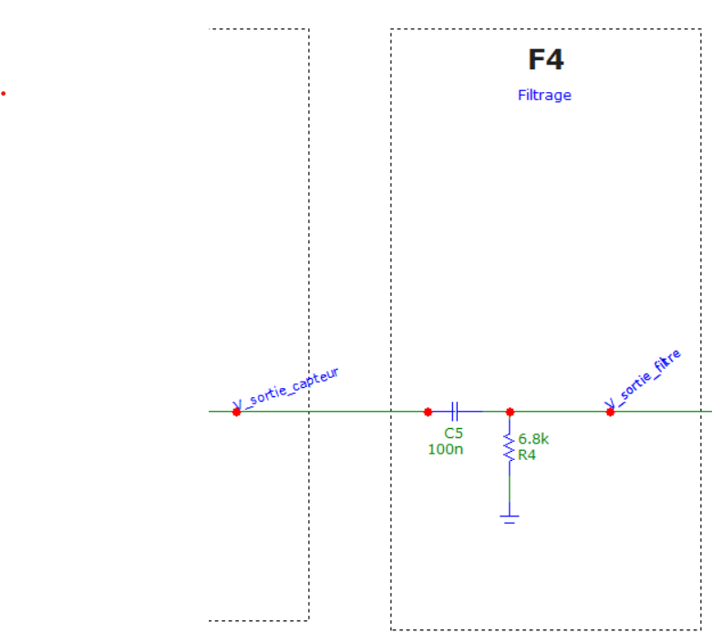
Rapports/3.Mettre en forme Vout/filtre.png
