Varas10/ROBOT/Rapports/3.Mettre en forme Vout/Ve et Vs seance 3.jpg

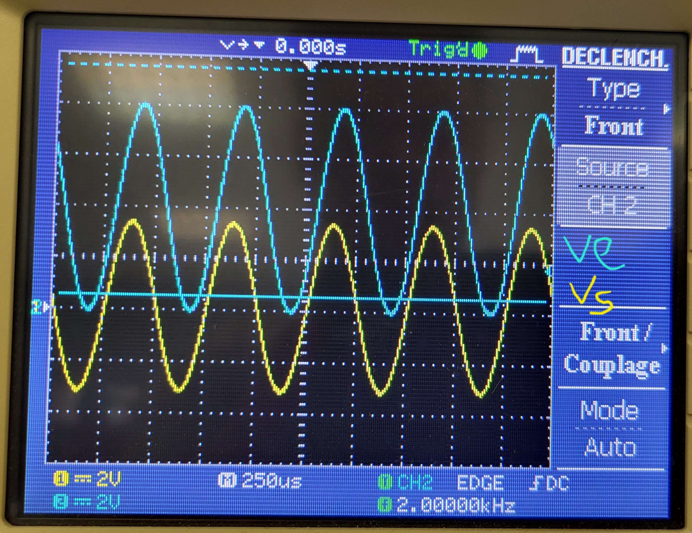
Rapports/3.Mettre en forme Vout/Ve et Vs seance 3.jpg
