Varas10/ROBOT/Rapports/4.Amplifier Vout filtrée/Ampli marqueur.png

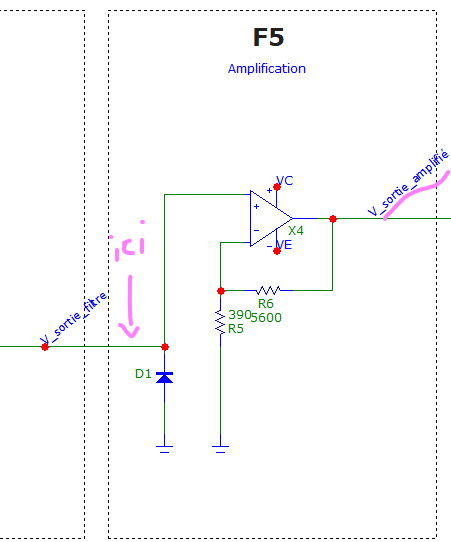
Rapports/4.Amplifier Vout filtrée/Ampli marqueur.png
