Varas10/ROBOT/Rapports/5.Démoduler Vout filtrée amplifié/detecteur crête 1.png

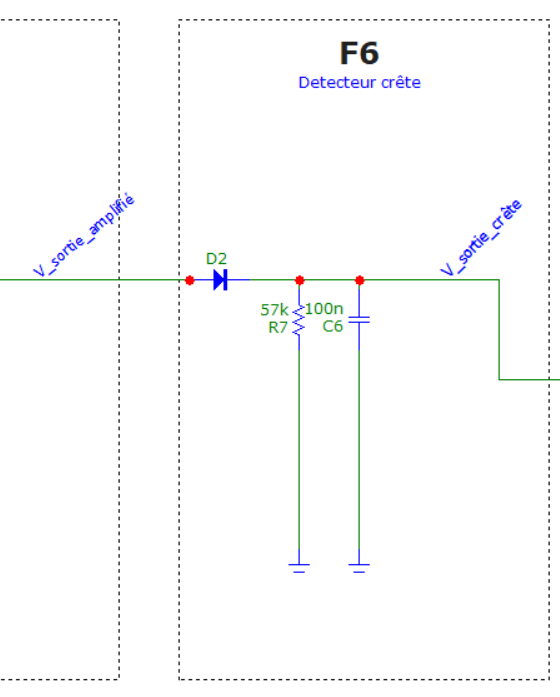
Rapports/5.Démoduler Vout filtrée amplifié/detecteur crête 1.png
