Varas10/ROBOT/Rapports/5.Démoduler Vout filtrée amplifié/Detecteur crête.png

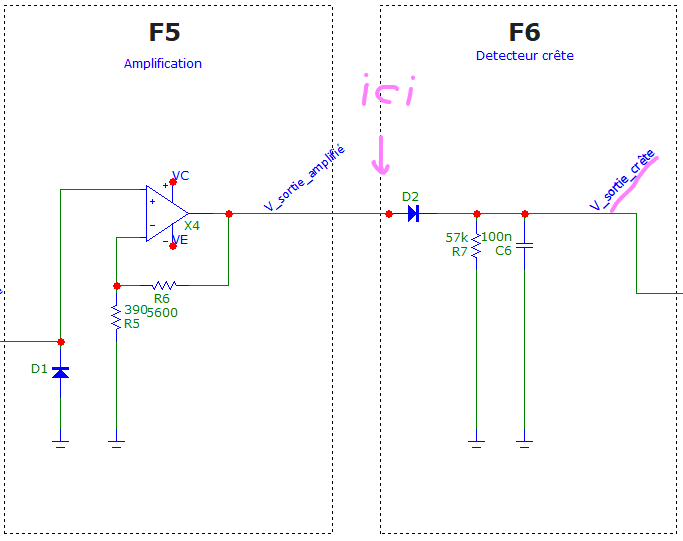
Rapports/5.Démoduler Vout filtrée amplifié/Detecteur crête.png
