Varas10/ROBOT/Rapports/5.Démoduler Vout filtrée amplifié/ve et vs seance5.jpg

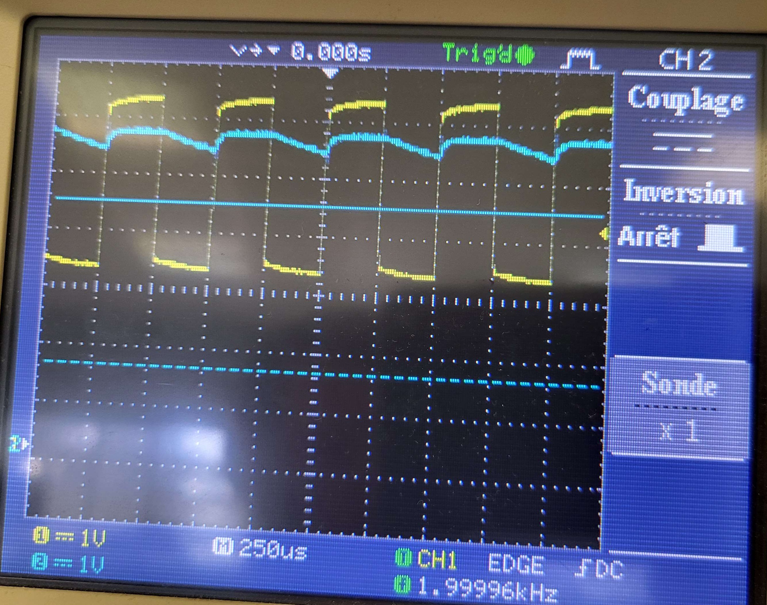
Rapports/5.Démoduler Vout filtrée amplifié/ve et vs seance5.jpg
