Varas10/ROBOT/Rapports/6. Visualiser/Led affichage.png

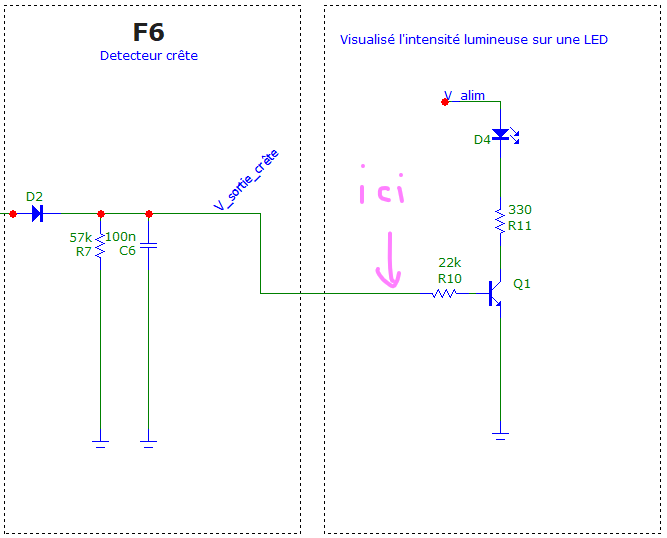
Rapports/6. Visualiser/Led affichage.png
