Varas10/ROBOT/Rapports/6. Visualiser/surface blanche- seance 6.jpg

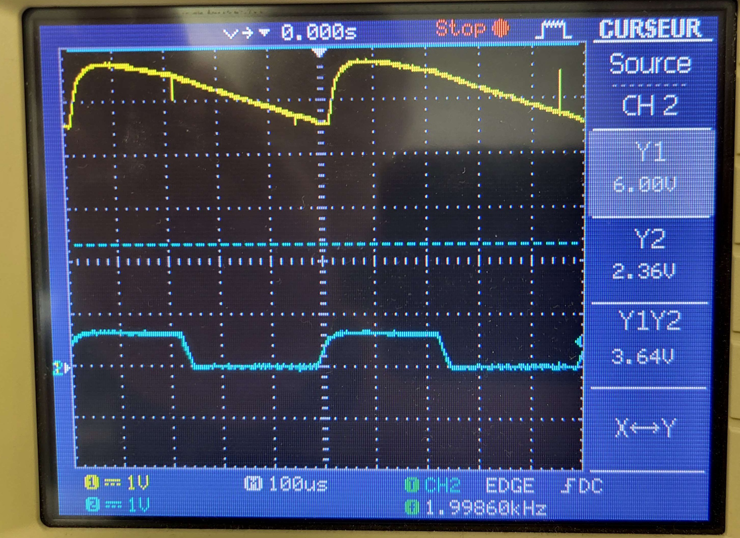
Rapports/6. Visualiser/surface blanche- seance 6.jpg
