Varas10/ROBOT/Rapports/6. Visualiser/surface noir - séance 6.jpg

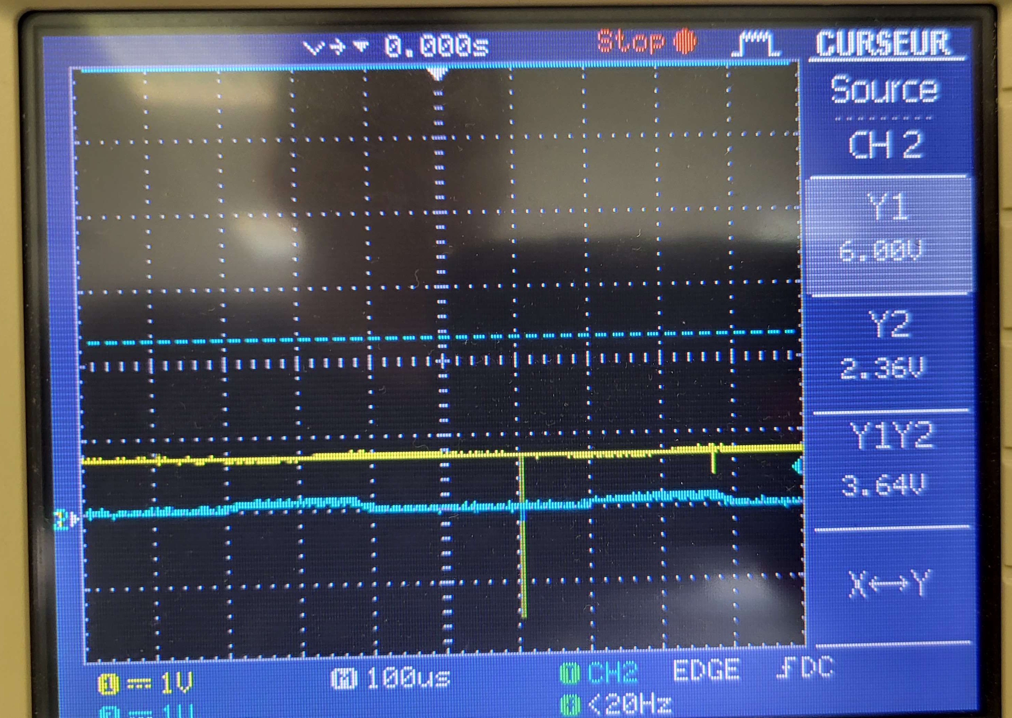
Rapports/6. Visualiser/surface noir - séance 6.jpg
