Varas10/ROBOT/Schéma globale.png

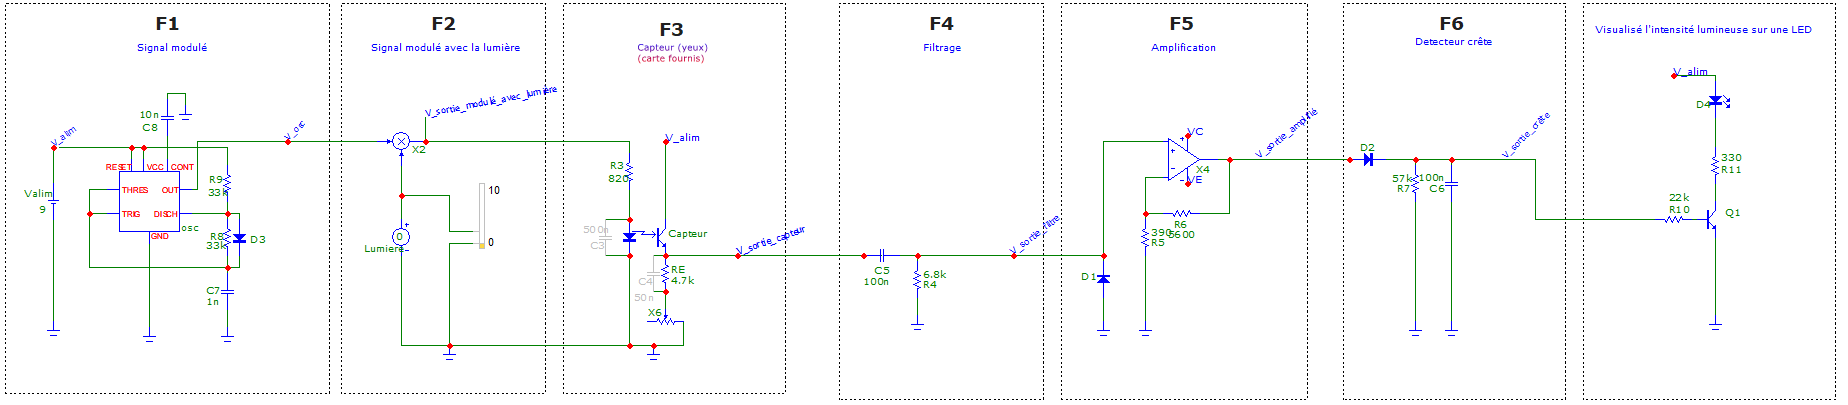
Schéma globale.png
