Varas10/ROBOT/Schéma d'assemblage du robot.pptx

Les composants seront vers l’avant du robot

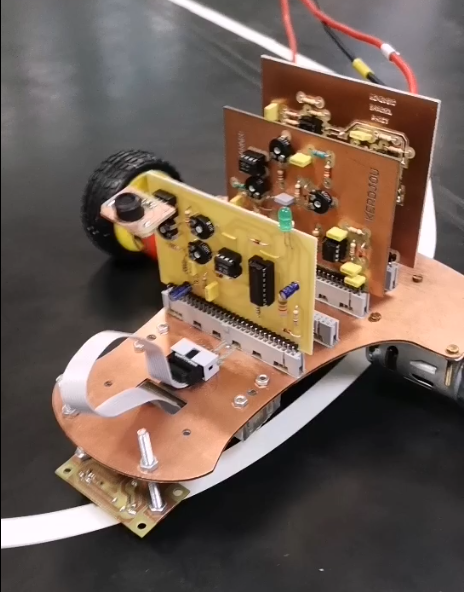
[picture p64: figure]

Signaux concernés pour la carte suivi En rouge

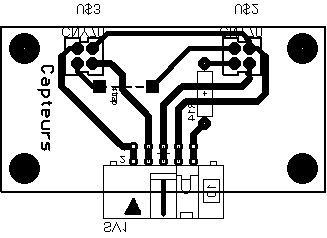
[picture p65: figure]

les capteurs sont
en-dessous

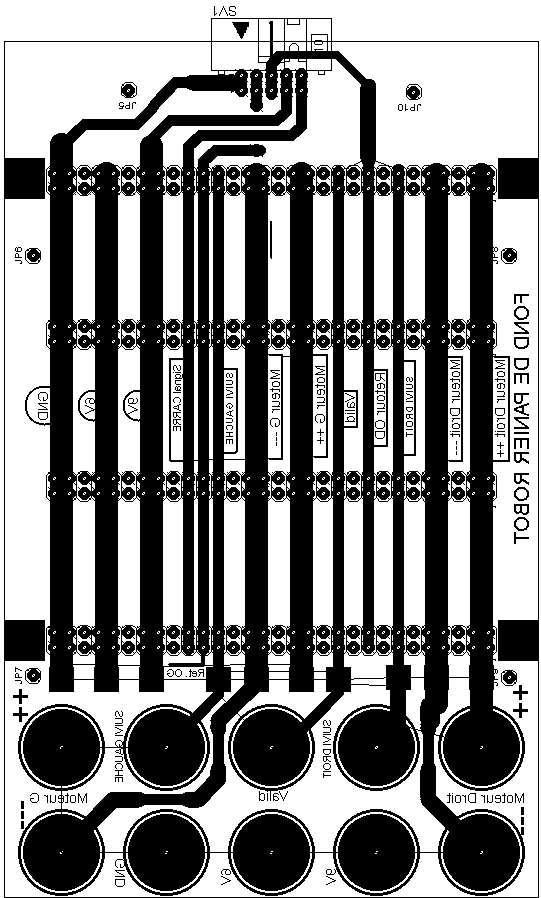
[picture p66: figure]

7,5 cm

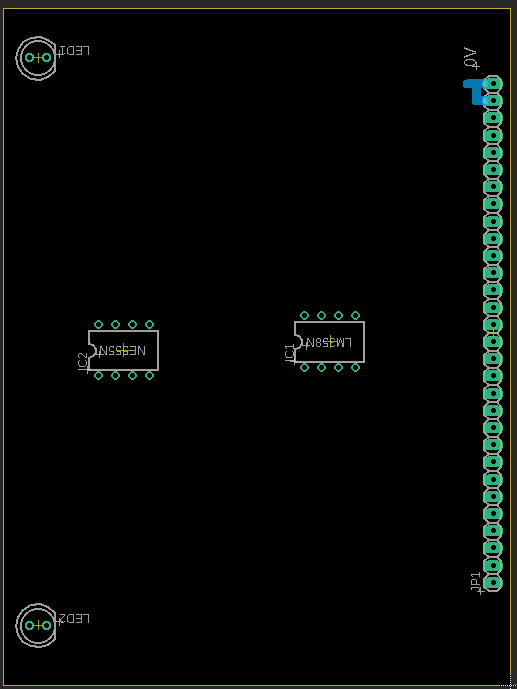
[picture p67: figure]
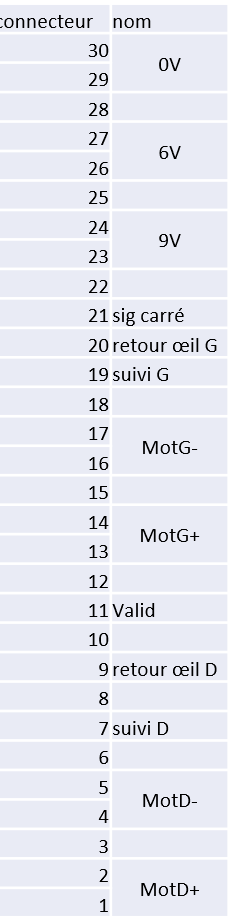
[picture p68: figure]

10cm

Avant du robot
