Varas10/ROBOT/Fichiers Simulations Carte SUIVI-20250411/Carte SUIVI.cir

[Main]
FileType=CIR
Version=12.00
Program=Micro-Cap
Component Version=10.00
Shape Version=11.00
Screen=1920,1080
MCAPVersion=12.2.0.5
Key ID=Demo
NLCnt=145
TXCnt=26

[shapedef]
Name=555
Rectangle=0,8,80,88
FColor=None
Line=0,32,-16,32
Line=0,64,-16,64
Line=40,88,40,104
Line=32,8,32,-8
Line=64,8,64,-8
Line=80,32,96,32
Line=16,8,16,-8
Line=80,64,96,64

[shapedef]
Name=Animated Analog Bar
Animated Analog Bar=0,0,16,88
FColor=#FF0000
Current=-16,56,0,56

[shapedef]
Name=Battery
Line=0,0,22,0
Line=22,-3,22,3
Line=26,-7,26,7
Line=26,0,48,0
Current=32,8,16,8

[shapedef]
Name=Bjt.root
Line=0,0,13,0
Rectangle=13,-12,15,12
Current=32,-24,32,-16
Current=32,24,32,16
Current=0,-8,8,-8
PolyOpen=3
PolyLine=24,-24
PolyLine=24,-12
PolyLine=14,-2
PolyOpen=3
PolyLine=24,24
PolyLine=24,12
PolyLine=14,2

[shapedef]
Name=Capacitor
Line=0,0,22,0
Line=22,-8,22,8
Line=26,-8,26,8
Line=26,0,48,0
Current=32,12,16,12

[shapedef]
Name=Circle.root
Ellipse=20,-12,44,12
FColor=None
Line=0,0,19,0
Line=32,32,32,12
Line=64,0,44,0
PolyClosed=3
PolyLine=13,-3
PolyLine=18,0
PolyLine=13,3
PolyClosed=3
PolyLine=32,14
PolyLine=35,19
PolyLine=29,19
Line=18,0,20,0

[shapedef]
Name=Diode
Root="Diode.root",0,0,0

[shapedef]
Name=Diode.root
Line=0,0,20,0
Line=28,0,48,0
Rectangle=18,-8,20,8
PolyClosed=3
PolyLine=20,0
PolyLine=28,-8
PolyLine=28,8
Current=32,16,16,16

[shapedef]
Name=Ground
Line=0,0,12,0
Line=12,-8,12,8
Line=18,-4,18,4
Line=24,0,24,0

[shapedef]
Name=LED2
Line=22,10,16,16
Line=30,10,24,16
PolyClosed=3
PolyLine=18,18
PolyLine=14,14
PolyLine=14,18
PolyClosed=3
PolyLine=26,18
PolyLine=22,14
PolyLine=22,18
Line=0,0,20,0
Line=28,0,48,0
Rectangle=18,-8,20,8
PolyClosed=3
PolyLine=20,0
PolyLine=28,-8
PolyLine=28,8

[shapedef]
Name=Minus.root
Line=-2,0,2,0

[shapedef]
Name=Mul
Root="Circle.root",0,0,0
Line=28,-4,36,4
Line=28,4,36,-4

[shapedef]
Name=NPN
Root="Bjt.root",0,0,0
PolyClosed=3
PolyLine=20,12
PolyLine=24,12
PolyLine=24,8

[shapedef]
Name=Opamp5
Root="Opamp.root",0,0,0
Root="Plus.root",25,-4,0
Root="Minus.root",25,52,0
Line=32,56,32,34
Line=32,-8,32,13

[shapedef]
Name=Opamp.root
Line=0,48,6,48
Line=0,0,5,0
Line=6,-4,6,52
Line=6,-4,48,24
Line=6,52,48,24
Line=48,24,72,24
Line=10,12,14,12
Line=12,10,12,14
Line=10,36,14,36
Line=4,0,6,0

[shapedef]
Name=Optocoupler
Line=0,47,0,27
Line=0,19,0,-1
Rectangle=-8,27,8,29
PolyClosed=3
PolyLine=0,27
PolyLine=-8,19
PolyLine=8,19
Rectangle=37,12,39,36
PolyOpen=3
PolyLine=48,0
PolyLine=48,12
PolyLine=38,22
PolyOpen=3
PolyLine=48,48
PolyLine=48,36
PolyLine=38,26
PolyClosed=3
PolyLine=44,36
PolyLine=48,36
PolyLine=48,32
Line=30,24,34,20
PolyOpen=5
PolyLine=4,16
PolyLine=20,16
PolyLine=16,20
PolyLine=34,20
PolyLine=30,16

[shapedef]
Name=Plus.root
Line=-2,0,2,0
Line=0,-2,0,2

[shapedef]
Name=Pot
Line=0,0,12,0
Line=12,0,14,-4
Line=14,-4,18,4
Line=18,4,22,-4
Line=22,-4,26,4
Line=26,4,30,-4
Line=30,-4,34,4
Line=34,4,36,0
Line=36,0,48,0
PolyClosed=4
PolyLine=24,4
PolyLine=24,4
PolyLine=22,8
PolyLine=26,8
Line=24,8,24,16

[shapedef]
Name=Resistor
PolyOpen=12
PolyLine=0,0
PolyLine=0,0
PolyLine=12,0
PolyLine=14,-4
PolyLine=18,4
PolyLine=22,-4
PolyLine=26,4
PolyLine=30,-4
PolyLine=34,4
PolyLine=36,0
PolyLine=48,0
PolyLine=48,0
Current=32,8,16,8

[shapedef]
Name=SPICE_V
Root="Vsource.root",0,0,0

[shapedef]
Name=Vsource.root
Line=0,0,12,0
Line=36,0,48,0
Ellipse=12,-12,36,12
FColor=None
Line=7,5,7,9
Root="Plus.root",41,7,0
Current=32,16,16,16

[compdef]
Name=Mul
Definition=Macro
Shape=Mul
Mask=4096
Used=12
memo=Multiplier Macro
Label Offset=47,3,15,18
PinCnt=3
Pin="PinA",a,0,0,-8,-3
Pin="PinB",a,4,4,4,0
Pin="PinC",a,8,0,-17,-2

[compdef]
Name=Voltage Source
Definition=VSpice
Shape=SPICE_V
Mask=5377
Used=78
memo=Voltage Source
Label Offset=19,13,15,13
PinCnt=2
Pin="Plus",6,0,-5,-6
Pin="Minus",0,0,-20,-6

[compdef]
Name=Ground
Definition=Ground
Shape=Ground
Mask=1281
Used=415
memo=Ground
Label Offset=0,0,0,0
PinCnt=1
Pin="PinA",0,0,-3,-7

[compdef]
Name=Animated Analog Bar
Definition=ANIMATED ANALOG BAR
Shape=Animated Analog Bar
Mask=0
memo=Animated Analog Bar
Label Offset=21,27,-65,27
PinCnt=2
Pin="Plus",0,8,-25,6
Pin="Minus",0,10,-29,5

[compdef]
Name=Capacitor
Definition=Capacitor
Shape=Capacitor
Mask=6401
Used=61
memo=Capacitor
Label Offset=16,12,12,12
PinCnt=2
Pin="Plus",6,0,-3,-5
Pin="Minus",0,0,-14,-5

[compdef]
Name=Resistor
Definition=Resistor
Shape=Resistor
Mask=6401
Used=463
memo=Resistor
Label Offset=18,6,8,11
PinCnt=2
Pin="Plus",6,0,-10,-4
Pin="Minus",0,0,-14,-4

[compdef]
Name=Opto
Definition=Subckt
Shape=Optocoupler
Mask=4096
memo=Optocoupler model - Christophe Basso
Label Offset=52,10,-8,6
PinCnt=4
Pin="A",a,0,0,4,9
Pin="K",a,0,6,4,4
Pin="C",a,6,0,-11,9
Pin="E",a,6,6,-11,4

[compdef]
Name=Opamp
Definition=Opamp
Shape=Opamp5
Mask=4097
Used=44
memo=Opamp
Label Offset=44,29,-14,39
PinCnt=5
Pin="Plus input",0,0,-31,-7
Pin="Minus input",0,6,-33,20
Pin="VEE",4,7,3,-5
Pin="Output",9,3,-13,-4
Pin="VCC",4,-1,5,14

[compdef]
Name=Battery
Definition=Battery
Shape=Battery
Mask=7425
Used=155
memo=Battery
Label Offset=19,7,10,13
PinCnt=2
Pin="Plus",6,0,-4,-5
Pin="Minus",0,0,-10,-5

[compdef]
Name=Diode
Definition=Diode
Shape=Diode
Mask=4353
Used=31
memo=Diode
Label Offset=17,10,12,12
PinCnt=2
Pin="Anode",6,0,-9,-8
Pin="Cathode",0,0,-20,-8

[compdef]
Name=555
Definition=Macro
Shape=555
Mask=20480
Used=4
memo=555 Timer Macro
Label Offset=87,72,-20,88
PinCnt=8
Pin="RESET",d,2,-1,-33,17
Pin="DISCH",a,12,8,-49,8
Pin="THRES",a,-2,4,20,7
Pin="TRIG",a,-2,8,20,8
Pin="OUT",d,12,4,-39,7
Pin="CONT",a,8,-1,5,17
Pin="VCC",a,4,-1,5,17
Pin="GND",a,5,13,3,-3

[compdef]
Name=Pot
Definition=Macro
Shape=Pot
Mask=4864
Used=3
memo=Potentiometer Macro
Label Offset=32,4,9,11
PinCnt=3
Pin="PINA",a,0,0,-13,-5
Pin="PINB",a,3,2,6,5
Pin="PINC",a,6,0,-12,-5

[compdef]
Name=NPN
Definition=NPN
Shape=NPN
Mask=4097
Used=18
memo=NPN Transistor
Label Offset=37,-17,-14,33
PinCnt=3
Pin="Collector",3,-3,4,14
Pin="Base",0,0,-18,-3
Pin="Emitter",3,3,5,1

[compdef]
Name=LR_A67F-TYP
Definition=Diode
Shape=LED2
Mask=4224
memo=625nm Red SIDELED LED Vf=2V If=30mA Pd=130mW
Label Offset=34,3,11,9
PinCnt=2
Pin="Anode",6,0,-12,-1
Pin="Cathode",0,0,-23,-1
Power=0.13

[Circuit]
Window Placement=2,3, -1,-1, -8,-31, 52,52,1201,482
Default Object=Color=#000000,Pattern=Dot6
Default Object Font=Height=-15,FStyle=0,Color=#000080,Name=Arial
Default Object Apply Border To Text=No
Default Object Apply Fill To Text=No
Default Object GridSnap=No
NodeVoltageFormat=3
CurrentFormat=3
PowerFormat=3
PathDelayFormat=3
WarningFormat=3
GridTextFormulaFormat=3
SpiceType=AMBIGUOUS
Title_Block_Border=None
Title_Block=False
Show Nodes=False
Show Voltages=False
Show Current=False
Show Power=False
Show Condition=False
Show Pin Connections=False
Show Connection Warnings=False
Show Cross=False
Show Attribute Text=True
Show Grid Text=True

[Object]
Object=FC_Process
CBorder=#000000
Pattern=Dot6
Px=40,248,472,768
GridSnap=True

[Comp]
Name=Mul
Px=536,432

[Attr]
ON=47,3,PART
V=X2
Style=8192

[Attr]
ON=47,17,FILE
V=Mul

[Attr]
ON=47,45,Param:SCALE
V=9/50

[Attr]
ON=0,0,PACKAGE
V

[Comp]
Name=Voltage Source
Px=568,584
Rot=3

[Attr]
ON=-49,-17,PART
V=Lumiere
Style=8192

[Attr]
ON=-7,-33,VALUE
V=0
Style=8192

[Attr]
ON=0,0,PACKAGE
V

[Wire]
Pxs=568,504,632,504

[Wire]
Pxs=568,584,568,704

[Wire]
Pxs=600,400,600,432

[Wire]
Pxs=632,704,872,704

[Comp]
Name=Ground
Px=632,704
Rot=7

[Comp]
Name=Animated Analog Bar
Color=#C0C0C0
FColor=#FDD844
Px=664,488

[Attr]
ON=21,27,PART
V=Bar1

[Attr]
ON=21,41,LOW
V=0

[Attr]
ON=21,55,HIGH
V=10

[Attr]
ON=0,0,PACKAGE
V

[Wire]
Pxs=632,568,632,704

[Wire]
Pxs=840,536,872,536

[Comp]
Name=Capacitor
Color=#C0C0C0
FColor=#C0C0C0
Px=840,584
Rot=5

[Attr]
ON=-20,-21,PART
V=C3
Style=8192
Color=#C0C0C0

[Attr]
ON=-30,-43,CAPACITANCE
V=500n
Style=8192
Color=#C0C0C0

[Attr]
ON=0,0,CHARGE
V
Color=#C0C0C0

[Attr]
ON=0,0,FREQ
V
Color=#C0C0C0

[Attr]
ON=0,0,MODEL
V
Color=#C0C0C0

[Attr]
ON=0,0,SMOKE
V
Color=#C0C0C0

[Attr]
ON=0,0,FSV
V
Color=#C0C0C0

[Attr]
ON=0,0,COST
V
Color=#C0C0C0

[Attr]
ON=0,0,POWER
V
Color=#C0C0C0

[Attr]
ON=0,0,PACKAGE
V
Color=#C0C0C0

[Comp]
Name=Resistor
Px=872,496
Rot=5

[Attr]
ON=-25,-40,PART
V=R3
Style=8192

[Attr]
ON=-28,-23,RESISTANCE
V=820
Style=8192

[Attr]
ON=0,0,PACKAGE
V

[Wire]
Pxs=872,496,872,536

[Comp]
Name=Opto
ShowPackagePins=True
Px=872,536

[Attr]
ON=52,10,PART
V=Capteur
Style=8192

[Attr]
ON=52,24,NAME
V=Opto

[Attr]
ON=0,0,PACKAGE
V

[Wire]
Pxs=872,584,872,704

[Comp]
Name=Capacitor
Color=#C0C0C0
FColor=#C0C0C0
Px=904,632
Rot=5

[Attr]
ON=-20,-21,PART
V=C4
Style=8192
Color=#C0C0C0

[Attr]
ON=-26,0,CAPACITANCE
V=50n
Style=8192
Color=#C0C0C0

[Attr]
ON=0,0,CHARGE
V
Color=#C0C0C0

[Attr]
ON=0,0,FREQ
V
Color=#C0C0C0

[Attr]
ON=0,0,MODEL
V
Color=#C0C0C0

[Attr]
ON=0,0,SMOKE
V
Color=#C0C0C0

[Attr]
ON=0,0,FSV
V
Color=#C0C0C0

[Attr]
ON=0,0,COST
V
Color=#C0C0C0

[Attr]
ON=0,0,POWER
V
Color=#C0C0C0

[Attr]
ON=0,0,PACKAGE
V
Color=#C0C0C0

[Wire]
Pxs=904,584,920,584

[Wire]
Pxs=920,632,920,656

[Wire]
Pxs=872,704,904,704

[Wire]
Pxs=920,432,920,536

[Wire]
Pxs=920,584,1016,584

[Comp]
Name=Resistor
Px=920,584
Rot=1

[Attr]
ON=8,11,PART
V=RE
Style=8192

[Attr]
ON=8,25,RESISTANCE
V=4.7k
Style=8192

[Attr]
ON=0,0,PACKAGE
V

[Comp]
Name=Ground
Px=904,704
Rot=7

[Object]
Object=FC_Process
CBorder=#000000
Pattern=Dot6
Px=488,248,760,768
GridSnap=True

[Wire]
Pxs=600,432,872,432

[Object]
Object=FC_Process
CBorder=#000000
Pattern=Dot6
Px=1152,248,1424,776
GridSnap=True

[Object]
Object=FC_Process
CBorder=#000000
Pattern=Dot6
Px=1824,248,2120,776
GridSnap=True

[Attr]
ON=0,0,VALUE
V
Style=8192

[Object]
Object=FC_Process
CBorder=#000000
Pattern=Dot6
Px=1448,248,1776,776
GridSnap=True

[Wire]
Pxs=568,704,632,704

[Wire]
Pxs=568,464,568,504

[Wire]
Pxs=632,552,664,552

[Wire]
Pxs=632,568,664,568

[Wire]
Pxs=568,504,568,536

[Wire]
Pxs=632,504,632,552

[Wire]
Pxs=872,432,872,448

[Wire]
Pxs=904,632,920,632

[Wire]
Pxs=904,704,944,704

[Wire]
Pxs=840,584,872,584

[Wire]
Pxs=296,432,416,432

[Comp]
Name=Ground
Px=2320,664
Rot=1

[Comp]
Name=Capacitor
Px=1232,584
Rot=6

[Attr]
ON=-33,12,PART
V=C5
Style=8192

[Attr]
ON=-48,26,CAPACITANCE
V=100n
Style=8192

[Attr]
ON=0,0,PACKAGE
V

[Comp]
Name=Resistor
Px=1256,640
Rot=5

[Attr]
ON=8,-25,PART
V=R4
Style=8192

[Attr]
ON=8,-39,RESISTANCE
V=6.8k
Style=8192

[Attr]
ON=0,0,PACKAGE
V

[Wire]
Pxs=1232,584,1256,584

[Wire]
Pxs=1256,584,1256,592

[Comp]
Name=Ground
Px=1256,664
Rot=7

[Wire]
Pxs=1256,640,1256,664

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

[Grid Text]
Text="V_osc"
Px=416,432
Angle=44
GridSnap=True
JustifyH=Left
JustifyV=Bottom
CBorder=None

[Grid Text]
Text="VC"
Px=48,32
GridSnap=True
JustifyH=Left
JustifyV=Bottom
Page=3
CBorder=None

[Grid Text]
Text="VC"
Px=1616,424
GridSnap=True
JustifyH=Left
JustifyV=Bottom
CBorder=None

[Grid Text]
Text="VE"
Px=112,32
GridSnap=True
JustifyH=Left
JustifyV=Bottom
Page=3
CBorder=None

[Grid Text]
Text="VE"
Px=1616,488
GridSnap=True
JustifyH=Left
JustifyV=Bottom
CBorder=None

[Grid Text]
Text="V_alim"
Px=104,440
Angle=35
GridSnap=True
JustifyH=Left
JustifyV=Bottom
CBorder=None

[Grid Text]
Text="V_alim"
Px=2264,344
GridSnap=True
JustifyH=Left
JustifyV=Bottom
CBorder=None

[Grid Text]
Text="V_alim"
Px=920,432
GridSnap=True
JustifyH=Left
JustifyV=Bottom
CBorder=None

[Grid Text]
Text="V_sortie_filtre"
Px=1384,584
Angle=38
GridSnap=True
JustifyH=Left
JustifyV=Bottom
CBorder=None

[Grid Text]
Text="V_sortie_amplifié"
Px=1712,456
Angle=39
GridSnap=True
JustifyH=Left
JustifyV=Bottom
CBorder=None

[Grid Text]
Text="V_sortie_crête"
Px=2040,456
Angle=45
GridSnap=True
JustifyH=Left
JustifyV=Bottom
CBorder=None

[Grid Text]
Text="Filtrage"
Px=1264,312
GridSnap=True
JustifyH=Left
JustifyV=Bottom
CBorder=None

[Grid Text]
Text="Signal modulé avec la lumière"
Px=528,312
GridSnap=True
JustifyH=Left
JustifyV=Bottom
CBorder=None

[Grid Text]
Text="Visualisé l'intensité lumineuse sur une LED"
Px=2160,288
GridSnap=True
JustifyH=Left
JustifyV=Bottom
CBorder=None

[Schematic]
CurrentSection 0=0
CurrentSection 1=0
CurrentSection 2=0
CurrentSection 3=0
Splitter.xs=0
Splitter.ys=0
TextQuad=4099
Scale=1.3333333333333333
GridUser=10
ShapeGroups="Main","Euro","Polarity","Main1","Main11","Electrolytic","GroundArrow","DeMorgan"
CalcRMS=False
CalcAVG=False
CalcPeak=False
CalcVoltage=True
DisplayMeasure=Last
ShareScales=True

[Tools]
Pos=Top
FILESAVEASOLD=No
BOM=No
FILEPCB=No
PROBE=Yes
SELECT=Yes
PAN=Yes
COMP=Yes
TEXT=Yes
WIRE=Yes
WIRED=Yes
BUS=Yes
GRAPHIC=Yes
FLOWCHART=Yes
LINE=No
ELLIPSE=No
RECT=No
DIAM=No
ARC=No
PIE=No
TRIANGLE=No
STAR=No
LEFTBRK=No
RIGHTBRK=No
BOTHBRK=No
META=Yes
PARALLELOGRAM=No
FC_PROCESS=No
FC_ALT_PROCESS=No
FC_DECISION=No
FC_DATA=No
FC_PREDEFPROCESS=No
FC_INTERNALSTORAGE=No
FC_DOCUMENT=No
FC_MULTIDOCUMENT=No
FC_TERMINATOR=No
FC_PREPARATION=No
FC_MANUALINPUT=No
FC_MANUALOPERATION=No
FC_CONNECTOR=No
FC_OFFPAGECONNECTOR=No
FC_PUNCHCARD=No
FC_PUNCHEDTAPE=No
FC_SUMMING_JUNCTION=No
FC_OR=No
FC_COLLATE=No
FC_SORT=No
FC_EXTRACT=No
FC_MERGE=No
FC_STORED_DATA=No
FC_DELAY=No
FC_SAS=No
FC_MAGNETIC_DISK=No
FC_DAS=No
FC_DISPLAY=No
SPREAD_SHEET=Yes
POLYCLOS=No
POLYOPEN=No
FLAG=Yes
INFO=Yes
HELP=Yes
HELP_SPICE=No
LINK=Yes
CHECK=Yes
REGION_ENABLE=Yes
TITLE_BLOCK=Yes
DIGTRC=No
DIGTRC2=No
BUILD_COMMAND=Yes
DIGALL=No
GRIDTEXT=Yes
COMPTEXT=Yes
NODE=Yes
MEASURED=Yes
NODEV=Yes
CURRENT=Yes
POWER=Yes
CONDITIN=Yes
PIN=Yes
CONNWARN=Yes
CROSS=Yes
GRID=Yes
BORDER=Yes
BORDERONE=Yes
TITLE=Yes
RUBBER=Yes
PROPERTY=Yes
STEP=Yes
MIRROR=Yes
ROTATE=Yes
FLIPY=Yes
FLIPX=Yes
CIR_MAKEMACRO=No
CLEARCUTWIRE=No
CLIPBOARDCIRPAGE2BMM=No
FINDCOMP=Yes
FIND=Yes
REPEAT=No
REPLACE=No
MODEL=Yes
CIR2CKT=Yes
ATTDISP=Yes
ENABLE=Yes
DISABLE=Yes
ENABLE_WITH=Yes
TOFRONT=Yes
TOBACK=Yes
SELNEXT=Yes
PAGEADD=Yes
PAGEADDTEXT=No
ADDSECTION=No
PAGEDEL=Yes
ZOOMIN=Yes
ZOOMOUT=Yes
AUTOSCALECIR=Yes
GOTOFLAG=Yes
UPLEVEL=Yes
COLOR=Yes
FONT=Yes
STYLE=Yes
DM_LAST=No
DM_RMS=No
DM_AVG=No
DM_PEAK=No
GRID_NONE=No
GRID_NORMAL=No
GRID_BOLD_5=No
GRID_BOLD_6=No
GRID_BOLD_USER=No
GRAPH_PAPER=No
SPLITCIRTEXTH=No
SPLITCIRTEXTV=No
SPACE_SPLITTERS_EVENLY=No
NORMALCIR=No
RENAMEDEFINE=No
RENAMECMP=No
ATTALIGN=No
RESETNODEPOS=No
FIT2STANDARD=No
NODESNAP=No
MOVETEXT=No
TEXTINC=No
TOGGLETEXT=No
TOGGLEMODE=No
TOLERANCE=No
ALIGNAB=No
ALIGNLEFT=Yes
ALIGNCENTER=Yes
ALIGNRIGHT=Yes
ALIGNTOP=Yes
ALIGNMIDDLES=Yes
ALIGNBOTTOM=Yes

[Section]
Index=0
Name="Carte SUIVI"
Type=Main
Enable=True
CurrentPage 0=0
CurrentPage 1=0
CurrentPage 2=0
CurrentPage 3=0
TabSize 0=425
TabSize 1=425
TabSize 2=425
TabSize 3=425

[Page]
Index=0
Section=0
Print=True
Enable=True
Name=Main
T.PrintPreview=Off,0,0,1,1
PrinterScale=1.0021261149139185
Scale 0=1
Scale 1=1
Scale 2=1
Scale 3=1.3333333333333333
Px=1428,934
WinBackGround Color=#FFFFFF
Select Color=#FF0000
Anchor Color=#000000
Select Box Color=#000080
Grid Text Color=Height=-12,FStyle=0,Color=#0000FF,Name=Verdana
Grid Text RTF=False
Grid Text Angle=0
Grid Text GridSnap=True
Grid Text PinIt=False
Grid Text JustifyH=Left
Grid Text JustifyV=Bottom
Grid GradientColor2=None
Grid OutlineThickness=1
Grid OutlineColor=None
Component Color=#0000FF
Attribute Text=Height=-12,FStyle=0,Color=#008000,Name=Verdana
Wire Color=#008000
Bus Color=#008000
Pin Connection=Height=-10,FStyle=0,Color=#FF0000,Name=Arial
Pin Marker Color=#008000
Node Number=Height=-11,FStyle=0,Color=#FF00FF,Name=Arial
Node Voltage Color=Height=-11,FStyle=0,Color=#000000,Name=Arial
Dynamic AC Voltage Color=#E4E4E4
Text Banner Text=Height=-15,FStyle=0,Color=#800000,Name=Arial
Title Block Background=#C0C0C0
Current=Height=-11,FStyle=0,Color=#0000FF,Name=Arial
Power/Condition=Height=-11,FStyle=0,Color=#FF0000,Name=Arial
Digital Path Color=#FF0000
Title Block Border=#000000
Disabled	Color=#C0C0C0
Search Color=#FFFF00
Grid Color=#000000
Graph Paper=#E4E4E4
Digital 0 Color=#000000
Digital R Color=#FFFF00
Digital F Color=#FFFF00
Digital 1 Color=#FF0000
Digital X Color=#C0C0C0
Digital Z Color=#808080
Block Select Color=#51F998

[Page]
Index=1
Section=0
Type=Text
Print=False
Enable=True
Name=Text
Font=Height=-15,FStyle=0,Color=#000000,Name=Courier New
Comment Color=#008000
WinBackGround Color=#FFFFFF
Disabled	Color=#C0C0C0
KeyWord Color=#0000FF
Error	Color=#FF0000
Search Color=#FFFF00

[Page]
Index=2
Section=0
Type=Text
Print=False
Enable=True
Name=Models
Font=Height=-15,FStyle=0,Color=#000000,Name=Courier New
Comment Color=#008000
WinBackGround Color=#FFFFFF
Disabled	Color=#C0C0C0
KeyWord Color=#0000FF
Error	Color=#FF0000
Search Color=#FFFF00

[Page]
Index=3
Section=0
Print=True
Enable=True
Name=Power Supplies
PrinterScale=1
Scale 0=1
Scale 1=1
Scale 2=1
Scale 3=0.5
Px=88,63
WinBackGround Color=#FFFFFF
Select Color=#FF0000
Anchor Color=#000000
Select Box Color=#000080
Grid Text Color=Height=-12,FStyle=0,Color=#0000FF,Name=Verdana
Grid Text RTF=False
Grid Text Angle=0
Grid Text GridSnap=True
Grid Text PinIt=False
Grid Text JustifyH=Left
Grid Text JustifyV=Bottom
Grid GradientColor2=None
Grid OutlineThickness=1
Grid OutlineColor=None
Component Color=#0000FF
Attribute Text=Height=-12,FStyle=0,Color=#008000,Name=Verdana
Wire Color=#008000
Bus Color=#008000
Pin Connection=Height=-10,FStyle=0,Color=#FF0000,Name=Arial
Pin Marker Color=#008000
Node Number=Height=-11,FStyle=0,Color=#FF00FF,Name=Arial
Node Voltage Color=Height=-11,FStyle=0,Color=#000000,Name=Arial
Dynamic AC Voltage Color=#E4E4E4
Text Banner Text=Height=-15,FStyle=0,Color=#800000,Name=Arial
Title Block Background=#C0C0C0
Current=Height=-11,FStyle=0,Color=#0000FF,Name=Arial
Power/Condition=Height=-11,FStyle=0,Color=#FF0000,Name=Arial
Digital Path Color=#FF0000
Title Block Border=#000000
Disabled	Color=#C0C0C0
Search Color=#FFFF00
Grid Color=#000000
Graph Paper=#E4E4E4
Digital 0 Color=#000000
Digital R Color=#FFFF00
Digital F Color=#FFFF00
Digital 1 Color=#FF0000
Digital X Color=#C0C0C0
Digital Z Color=#808080
Block Select Color=#51F998

[Page]
Index=4
Section=0
Type=Info
Print=False
Enable=True
Name=Info
Font=Height=-15,FStyle=0,Color=#000000,Name=Courier New
Comment Color=#008000
WinBackGround Color=#FFFFFF
Disabled	Color=#C0C0C0
KeyWord Color=#0000FF
Error	Color=#FF0000
Search Color=#FFFF00

[Text Area]
Section=0
Page=1
Text=.OPTIONS ITL4=50
Text=.OPTIONS ITL1=250
Text=.OPTIONS PIVREL=1

[Text Area]
Section=0
Page=2
Text=* Schematic File
Text=*
Text=* Syntax:
Text=* .MODEL <model name> [AKO:<reference model name>] <ModelType>
Text=* +([<parameter name>=<value>][LOT[/#][/GAUSS|/UNIFORM|/WCASE]=[<tol>[%]] |[-<low>%,<high>%]][DEV[/#][/GAUSS|/UNIFORM|/WCASE]=[<tol>[%]]...)
Text=* ModelType must be one of OPA,D,NPN,NMOS,NJF,PUL,SIN,TRN,CORE,GASFET,VSWITCH,ISWITCH,CAP,IND,RES,PNP,PMOS,PJF,DOUTPUT,DINPUT,UADC,UDAC,UGATE,UTGATE,UEFF,UGFF,UDLY,UPLD,UROM,URAM,UBGT,UIO,LPNP,NIGBT,I,V
Text=*
Text=*Examples:
Text=* .MODEL 2N2222A NPN(BF=150 IS=1E-14)
Text=* .model M1 NMOS(KP=2.5E-5 VTO=1.345 CGDO=14.67p CGBO=4.566p)
Text=* .MODEL DK D(IS=1E-18)
Text=* .model 2N2222A AKO:2N2222 NPN (BF=55 ISE=10F)
Text=* .Model BJT1 NPN (RE=12 LOT/1/GAUSS=30% DEV/2/UNIFORM=2%)
Text=*
Text=* A .cir file is typically found in the data directory
Text=*
Text=.MODEL COMP1 OPA ()

[InfoPage]
InfoPage=True
Warnings=True
System=True
Defines=True
Array=True
Model=True
Measure=True
MacroSubckt=True
NotUsed=True
ComponentCounts=True
VariablizePaths=False
DontShowPaths=False
SimulationLog=True

[Transient]
WinID=1
Font=Height=-19,FStyle=0,Color=#0000FF,Name=Arial
WinBackGround Color=#FFFFFF
Select Color=#FF0000
Anchor Color=#000000
Select Box Color=#000080
Title=suivi séance 2 ETUDIANT .cir
AutoTitle=Yes
Grid Color=#808080
Grid Weight=1
Grid Pattern=Dot6
Tracker Foreground=Height=-15,FStyle=0,Color=#000000,Name=Arial
Tracker Background=#FFFF00
Baseline color=#0000FF
BaseLine Weight=1
CurveFit color=#FF0000
CurveFit Weight=2
CurveFit Pattern=Dash
Static Grids=False
PlusMark=False
MinorLog25=Off
LabelMinor=Off
DataPoints=False
Token=False
Ruler=False
XAxisGrids=True
YAxisGrids=True
MinorLogGrids=True
BaseLine=False
AlignZ=True
Align Cursors=True
TagFormatX=3
TagFormatY=3
FormulaFormat=2
EndMode=SCALE
Graph Background=#FFFFFF
Tracker Intercept=False
Tracker Mouse=True
Tracker Cursor=True
Tracker Cursor BranchInfo=False
Horizontal Cursor=False
Same Y Scales=Yes
Enable X Scaling=True
Enable Y Scaling=True
Keep X Scales The Same=True
Number of Grids X=5
Number of Grids Y=5
Cursor Select Color Primary=#C0C0C0
Cursor Select Color Secondary=#FF0000
Data Point Labels Color Fore=Height=-15,FStyle=0,Color=#000000,Name=Arial
Data Point Labels Color Back=#FFFF00
OperPoint=True
OperPointOnly=False
AutoScaleRanges=True
FixedTimeStep=False
DoPSS=False
PSS_Periods="1"
PSS_Iterations="5"
PSS_Error="1u"
PSS_ShowPlots=True
FFT_NPts="8192"
FFT_IncludeDCHarmonic=False
FFT_AutoScale_Harmonics="10"
PrinterAutoTile=No
PrinterBlackBorder=No
AnimateWait=None
AnimateWaitTime=500
AnimatePressAfter=0
Save_For_Future=No
Reduce_Display=1
Reduce_Save=1
Reduce_ThrowDataOut=0
Num Out Header Left
Num Out Header Center="$MC\n$user\n$company\n$Analysis of $name\n$date $time"
Num Out Header Right
Num Out Delimiter=32
Num Out Write=True
Num Out Write Main Header=True
Num Out Write Limits=True
Num Out Write Branch Header=True
Num Out Write Models=False
Num Out Write Zero Models=True
Num Out Write Undefined Models=True
Num Out Write Operating Point=True
Num Out Write Measurement Values=True
Num Out Write Tolerance Detail=True
Num Out Write Values=True
Num Out Write Waveform Header=True
Num Out Allow Dup Y Expr=False
Num Out Low="TSTART"
Num Out High="TMAX"
Num Out Font=Height=-15,FStyle=0,Color=#000000,Name=Courier New
Num Out Format=3
Num Out HideNonSelected=False
Num Out UseActualDataPoints=False
AutoSaveWave=False
Wave Format=16E
State Variables Format=5E
Print Individual Pages=False
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
