Varas10/ROBOT/facicule julien/simu/led/led.asc

D1: LED
Q1: npn
R1: res
R2: res
V1: voltage; PULSE(0 6 0u 0u 0u 250u 500u)
V2: voltage; 9
Named nets: 0, V_det_crète
