Varas10/ROBOT/facicule julien/simu/Passe_Haut/passe haut.asc

C1: cap; 100n
R1: res; 6800
V1: voltage; SINE(7 5 2000)
Named nets: 0
VLum
VLumOut
.tran 0 1m 0 1u
