Varas10/ROBOT/facicule julien/simu/detecteur de crète/detecteur de crète.asc

C1: cap; 100n
D1: diode; 1N4148
R1: res; 50k
V1: voltage; PULSE(0 6 0 0 0 250u 500u)
Named nets: 0
.tran 0 5m 0 5u
