Varas10/ROBOT/facicule julien/simu/ampli/ampli.asc

D1: diode; 1N4148
R1: res; 680; tol=10 pwr=250m
R2: res; 150; tol=10 pwr=250m
U1: UniversalOpAmp
V1: voltage; SINE(0 1.5 2000 0 0)
V2: voltage; 9
Named nets: 0
.tran 0 1m 0 1u
