Varas10/ROBOT/facicule julien/simu/oscilateur/circuit oscilateur.asc

C1: cap; 1n
C2: cap; 10n
D1: diode; 1N4007
R1: res; 720k
R2: res; 720k
U1: NE555
V1: voltage; 9
Named nets: 0
.tran 0 10m 0 10m
