Varas10/ROBOT/(list of files, drawings)

Other design files:
eagle/Julien/fichier de fabrication/TEST2.PCB
eagle/Julien/fichier de fabrication/TEST.PCB
