Varas10/ROBOT/(commit log)

2025-03-23 fichier de simulation
2025-04-11 ajout des simu et réponses pour F2
    [Infos Simu SUIVI .xlsx]
2025-04-22 Create Rapport Emettre et Recevoir de la lumière ».md
2025-04-22 ajout des courbes en fonction du sol
2025-04-22 Update Rapport Emettre et Recevoir de la lumière ».md
2025-04-27 passage du facicule de pdf a docx
2025-05-04 contruction passe haut
    pas les valeurs
2025-05-04 calculs est simu du filtre
    [filtre RC pour 1kHz.xlsx]
2025-05-04 ajout des calculs et maj du diag de bode
    [filtre RC pour 1kHz.xlsx]
2025-05-05 fin du tp
    [filtre RC pour 1kHz.xlsx]
2025-05-06 Create Infos Simu SUIVI .xlsx
    [Infos Simu SUIVI .xlsx]
2025-05-07 ajout diode
2025-05-07 Update montage ampli + diode.png
2025-05-07 Rapport generer un signal de lumiere codée
2025-05-17 ajout fichier
    [Infos Simu SUIVI .xlsx]
2025-05-17 ajout micro cap + excel
    [Infos Simu SUIVI .xlsx, c'est ce fichier qui marche, les autres je ne sais pas à quoi ils servent.xlsx]
2025-05-18 Modif schéma elecrique
    ajout des titre de chaque fonction
2025-05-19 fin du dossier excel ultra chiant et inutile sa mère
    [c'est ce fichier qui marche, les autres je ne sais pas à quoi ils servent.xlsx]
2025-05-19 Assemblage de tout les rapports en un eul
2025-05-19 jean neymar
    plein de choses, rapport améliorer et rectification des erreurs. Ajout de schéma. Plein de chronogrammes ajouté (certains je ne sais pas ou les mettres) bref c'est un bordel et ca me fais chié. PUTAINT DE RAPPORT DE MERDE
2025-05-20 constructiion de la présentation de notre carte
2025-05-22 Create carte suiveur.sch
    [carte suiveur.sch]
2025-05-22 maj eagle
    [carte suiveur.sch]
2025-05-22 maj shéma
    [carte suiveur.sch]
2025-05-24 maj carte suivi
    [carte suiveur.sch]
2025-05-26 séparation eagle evan et julien
    [carte suiveur.brd, carte suiveur.sch, suiveur_evan.brd, suiveur_evan.sch]
2025-05-26 changement nom dossier
    [carte suiveur.brd, carte suiveur.sch, suiveur_evan.brd, suiveur_evan.sch]
2025-05-26 carte suiveur evan eagle
    [suiveur_evan.brd]
2025-06-01 itération 1 + 2 de la carte
    [carte suiveur.brd, carte suiveur.sch]
2025-06-01 maj iteration2
    [carte suiveur.brd]
2025-06-01 ité 3 plan de mass + ité 3
    [carte suiveur.brd, carte suiveur.sch]
2025-06-02 supr eagle evan + rapport
    [suiveur_evan.brd, suiveur_evan.sch]
2025-06-02 ité 4 + ité 4 masse
    [carte suiveur.brd, carte suiveur.sch]
2025-06-02 maj ité 4
    [carte suiveur.brd]
2025-06-05 dernière carte
    [carte suiveur.brd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]
2025-06-13 réduction des images
2025-06-13 ajout cahier des charges
2025-06-14 test carte
    [TEST.PCB, TEST2.PCB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]
